bensdev-p/retro_machine_cad/docs/reference/physical-specification.png

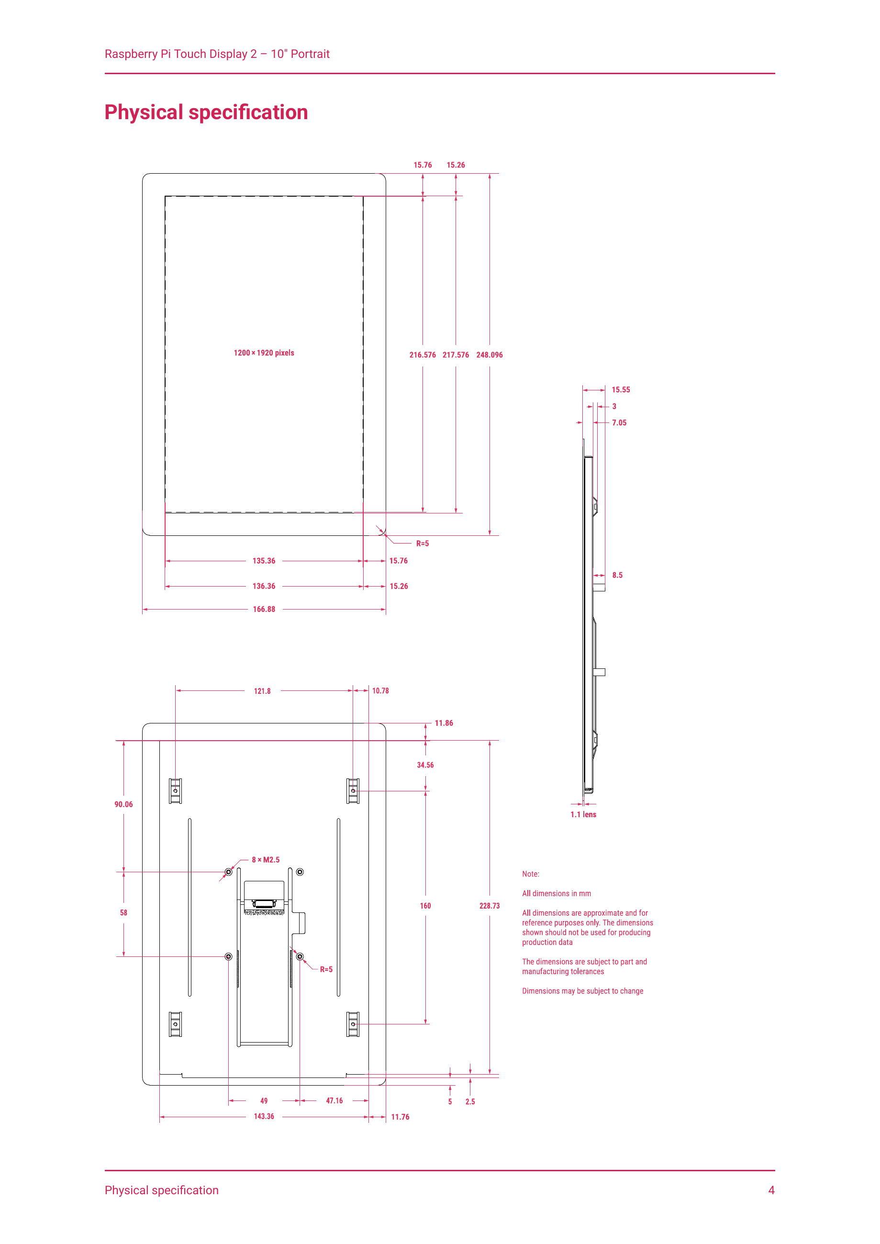
docs/reference/physical-specification.png
