bensdev-p/retro_machine_cad/outputs/front.png

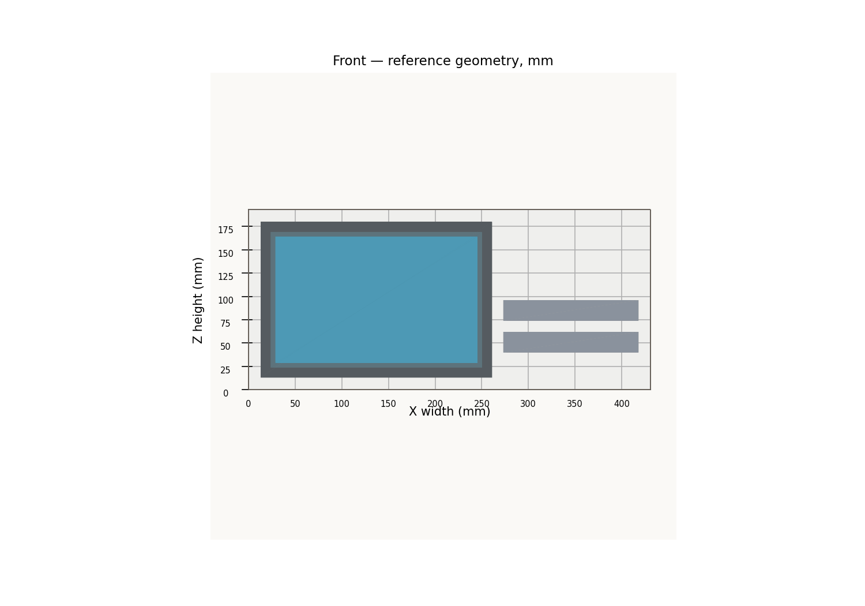
outputs/front.png
