bensdev-p/retro_machine_cad/outputs/keyboard_comparison.png

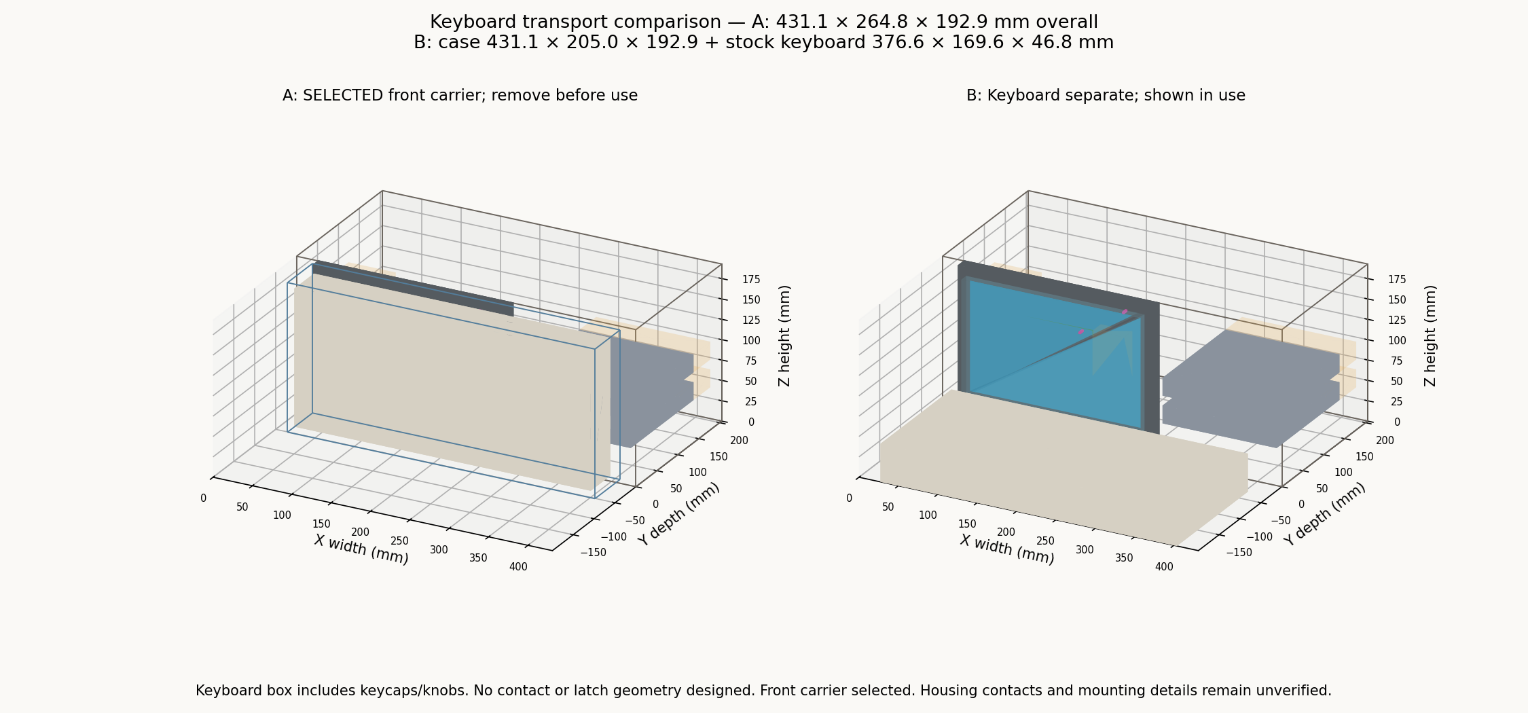
outputs/keyboard_comparison.png
