bensdev-p/retro_machine_cad/outputs/layout_views.png

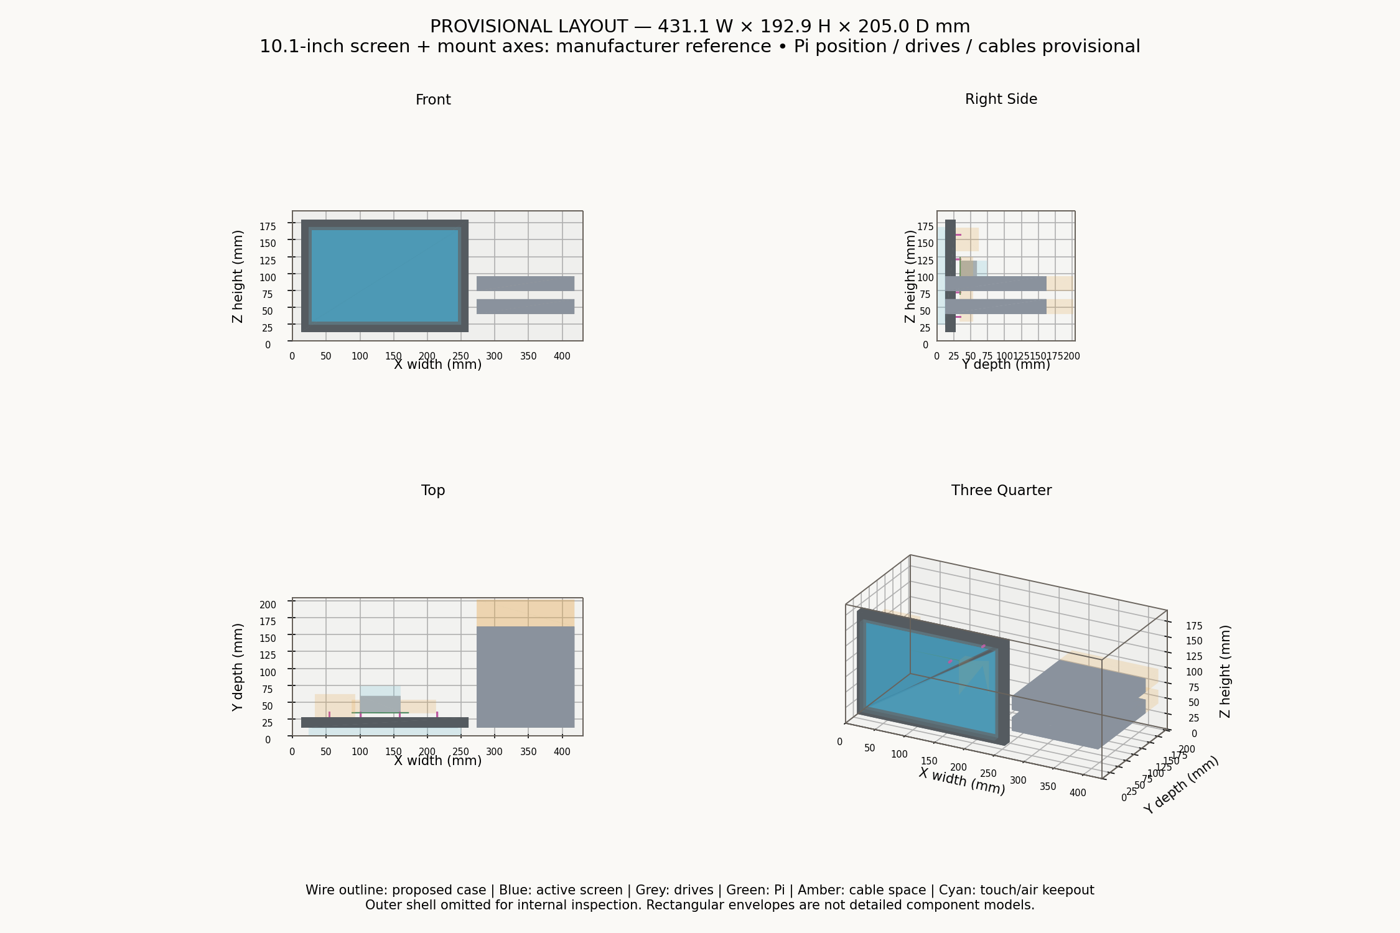
outputs/layout_views.png
