bensdev-p/retro_machine_cad/outputs/p2/previews/04_closed_classic.png

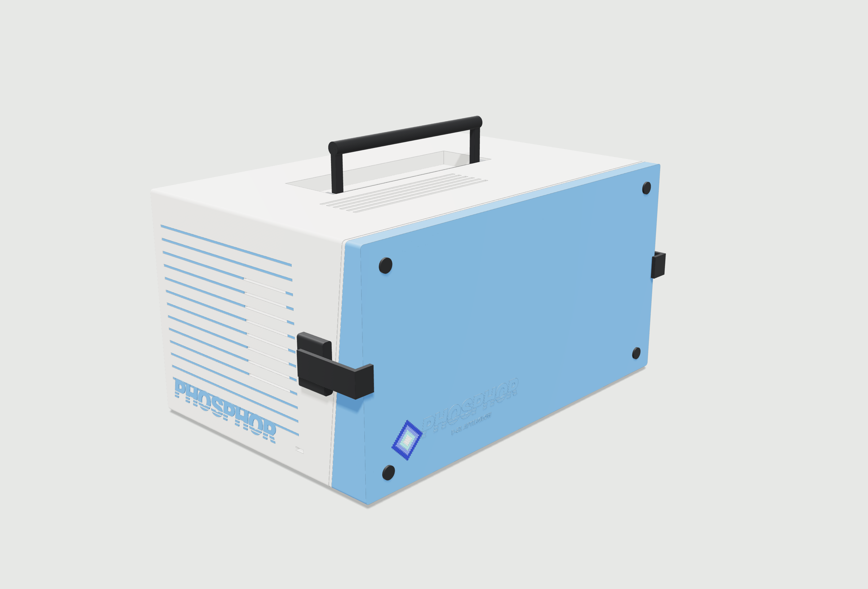
outputs/p2/previews/04_closed_classic.png
