bensdev-p/retro_machine_cad/outputs/p2/previews/05_rear_drawer.png

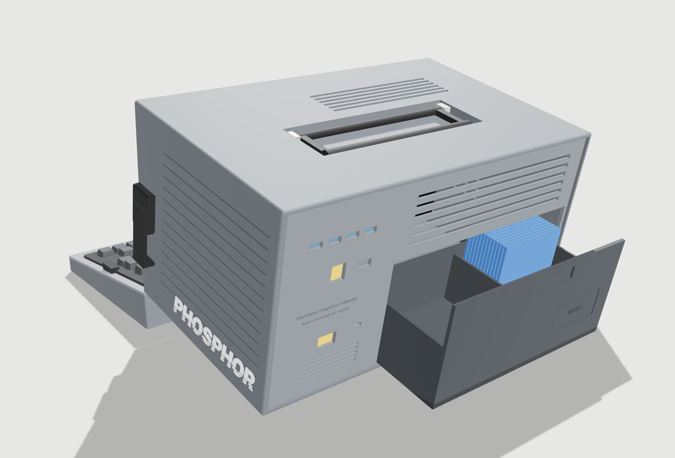
outputs/p2/previews/05_rear_drawer.png
