bensdev-p/retro_machine_cad/outputs/p2/previews/06_xray.png

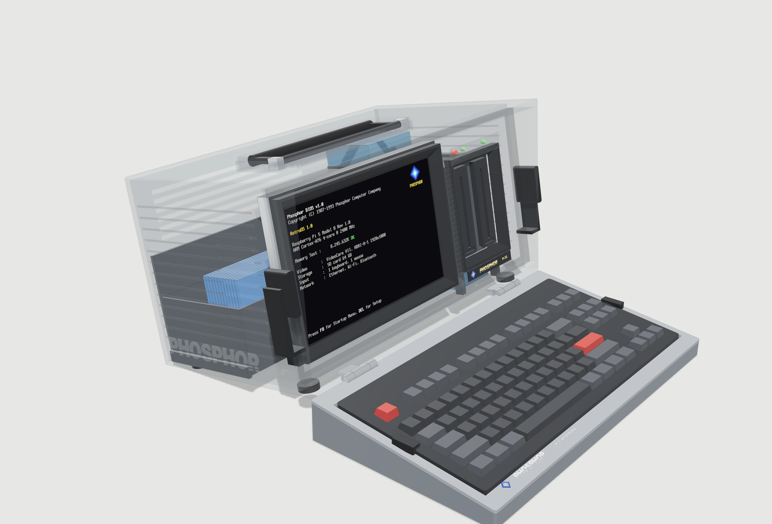
outputs/p2/previews/06_xray.png
