bensdev-p/retro_machine_cad/outputs/p2/previews/07_front.png

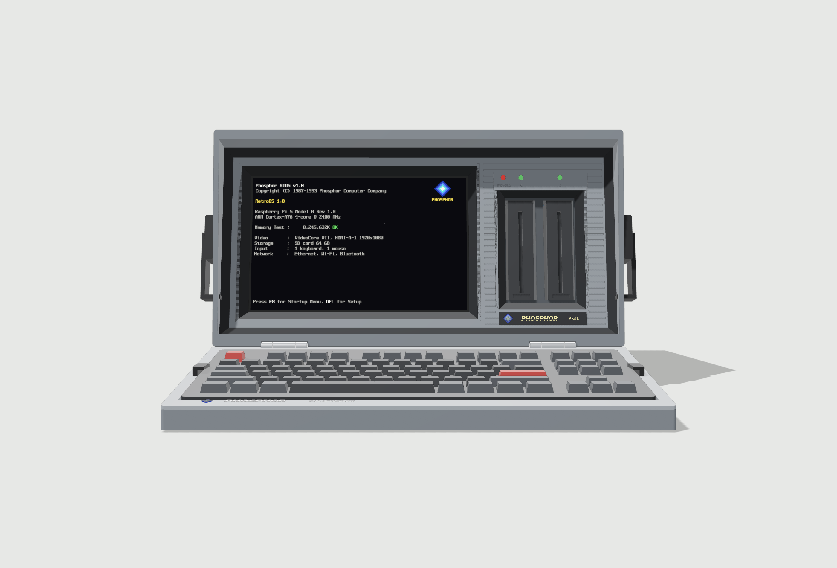
outputs/p2/previews/07_front.png
