bensdev-p/retro_machine_cad/outputs/p2/previews/08_side_closed.png

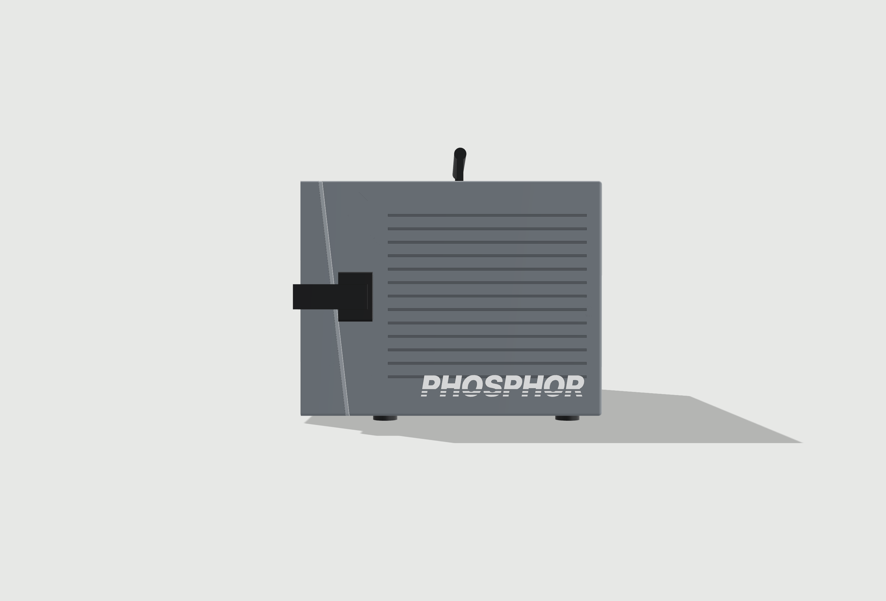
outputs/p2/previews/08_side_closed.png
