bensdev-p/retro_machine_cad/outputs/p2/screens/post.png

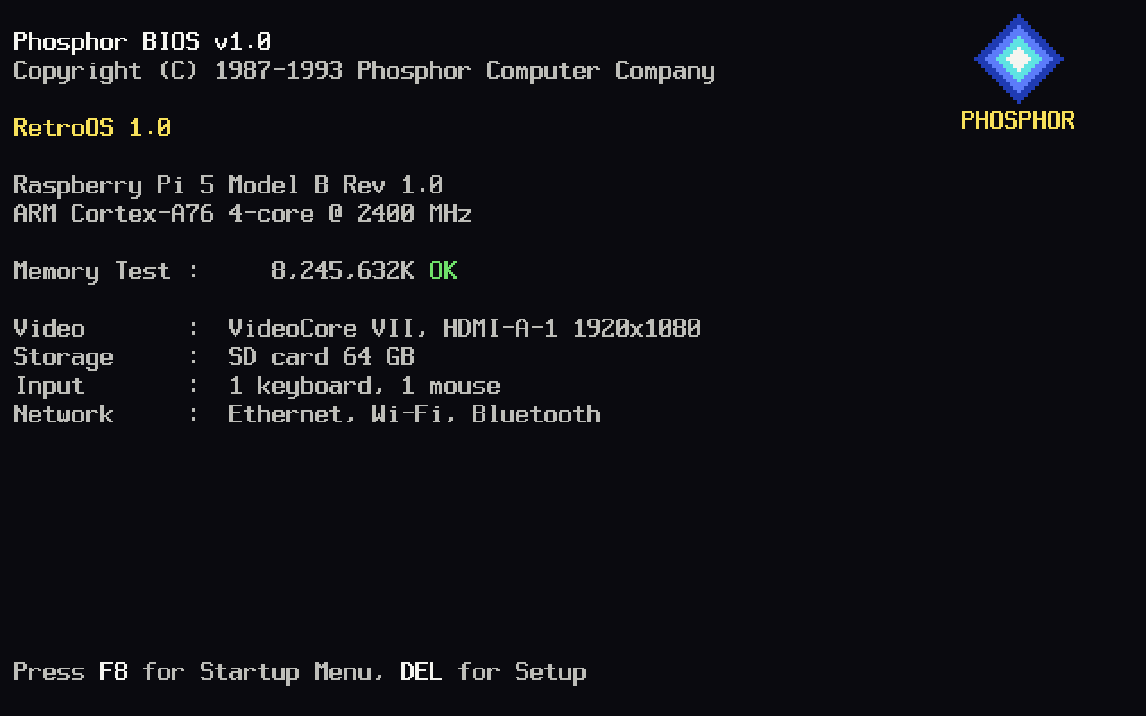
outputs/p2/screens/post.png
