bensdev-p/retro_machine_cad/outputs/p3/previews/p3_02_exploded.png

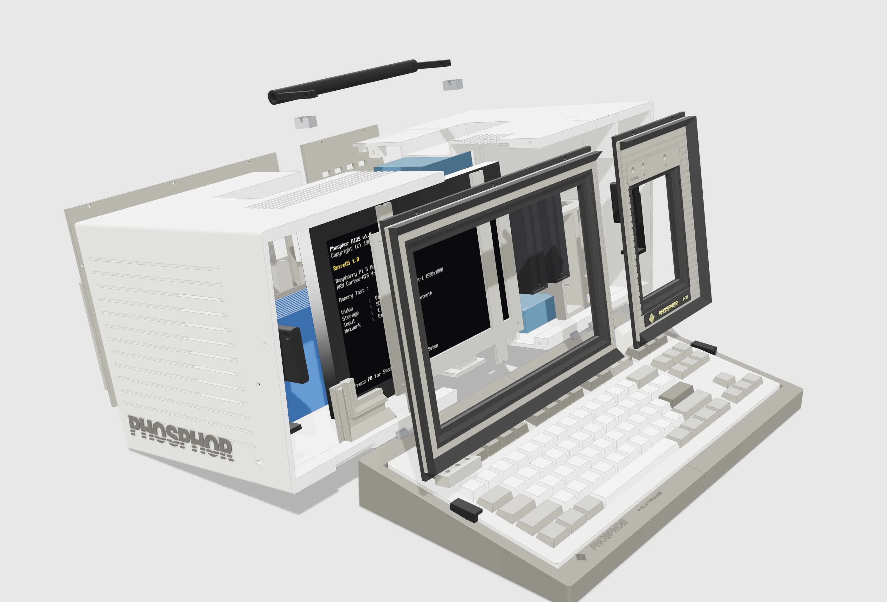
outputs/p3/previews/p3_02_exploded.png
