bensdev-p/retro_machine_cad/outputs/p3/previews/p3_04_xray.png

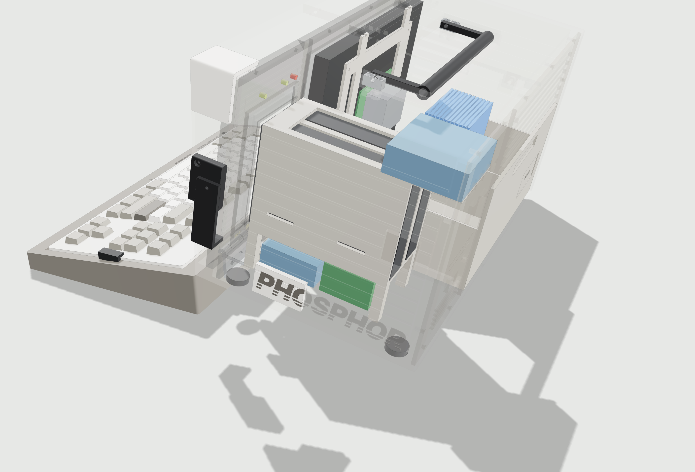
outputs/p3/previews/p3_04_xray.png
