bensdev-p/retro_machine_cad/outputs/prototype/previews/02_transport.png

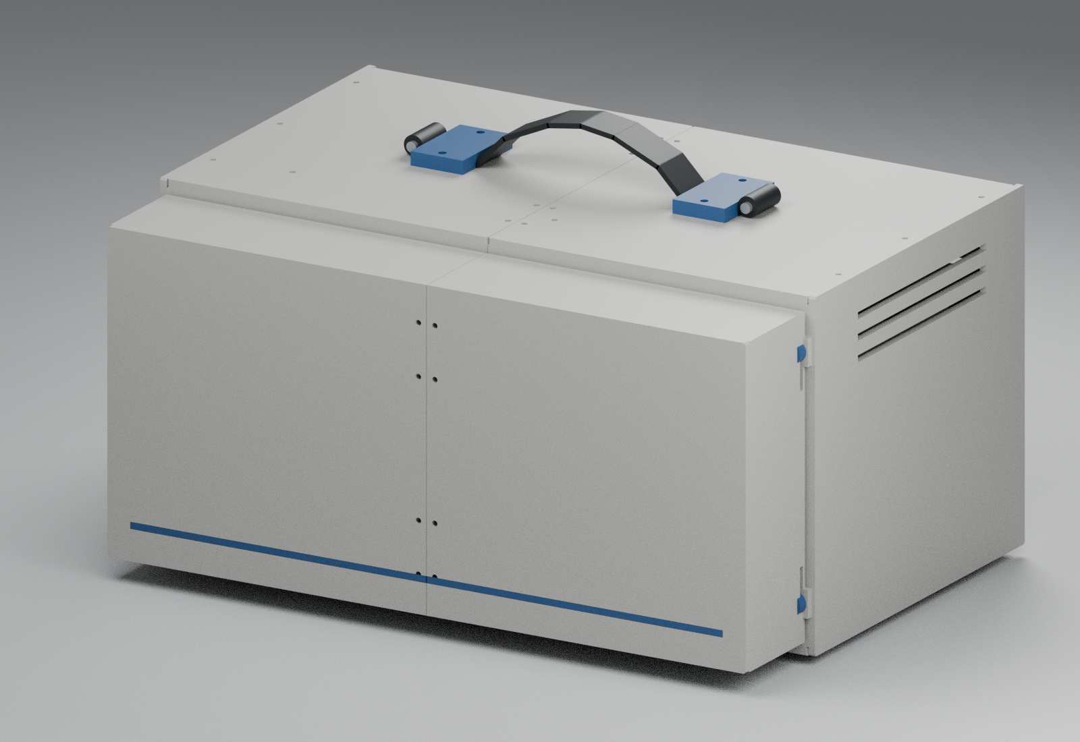
outputs/prototype/previews/02_transport.png
