bensdev-p/retro_machine_cad/outputs/prototype/previews/03_rear.png

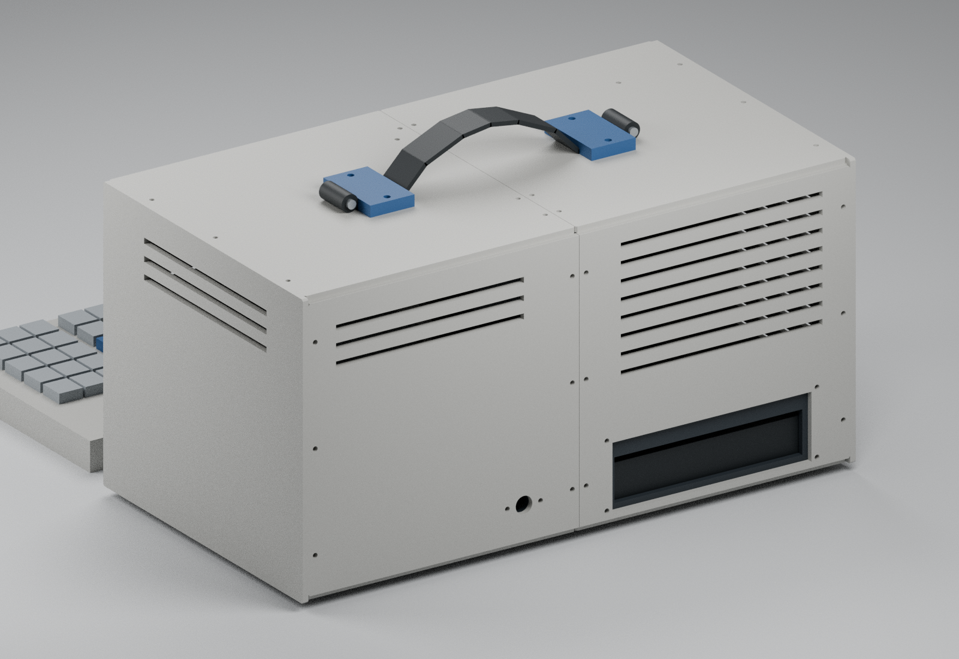
outputs/prototype/previews/03_rear.png
