bensdev-p/retro_machine_cad/outputs/prototype/previews/04_exploded.png

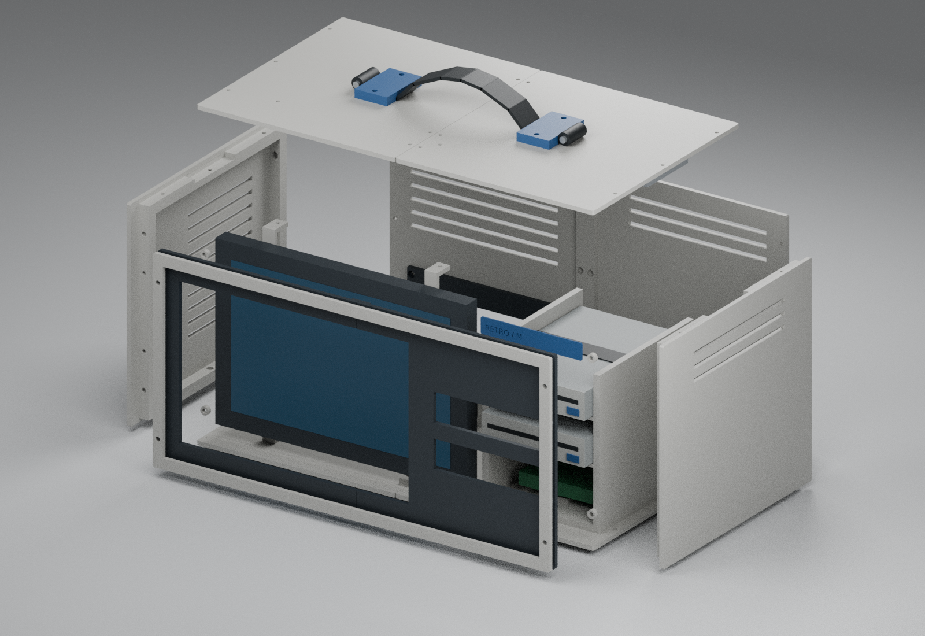
outputs/prototype/previews/04_exploded.png
