bensdev-p/retro_machine_cad/outputs/prototype/previews/05_front.png

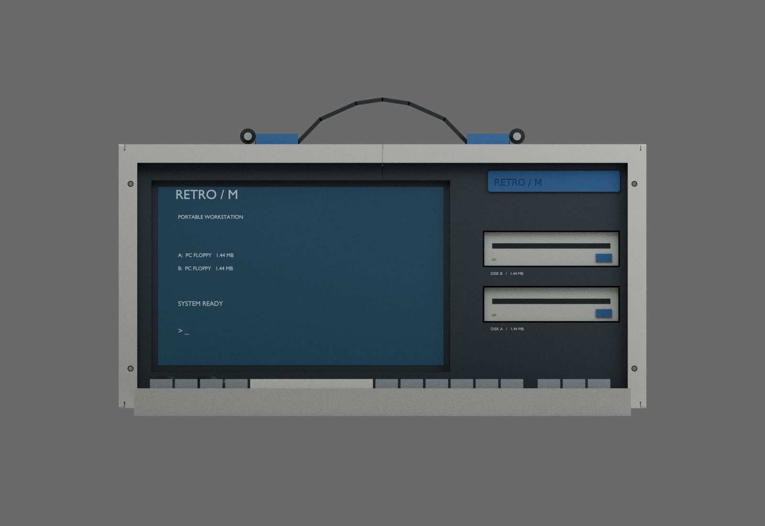
outputs/prototype/previews/05_front.png
