bensdev-p/retro_machine_cad/outputs/prototype/previews/06_interactive_viewer.png

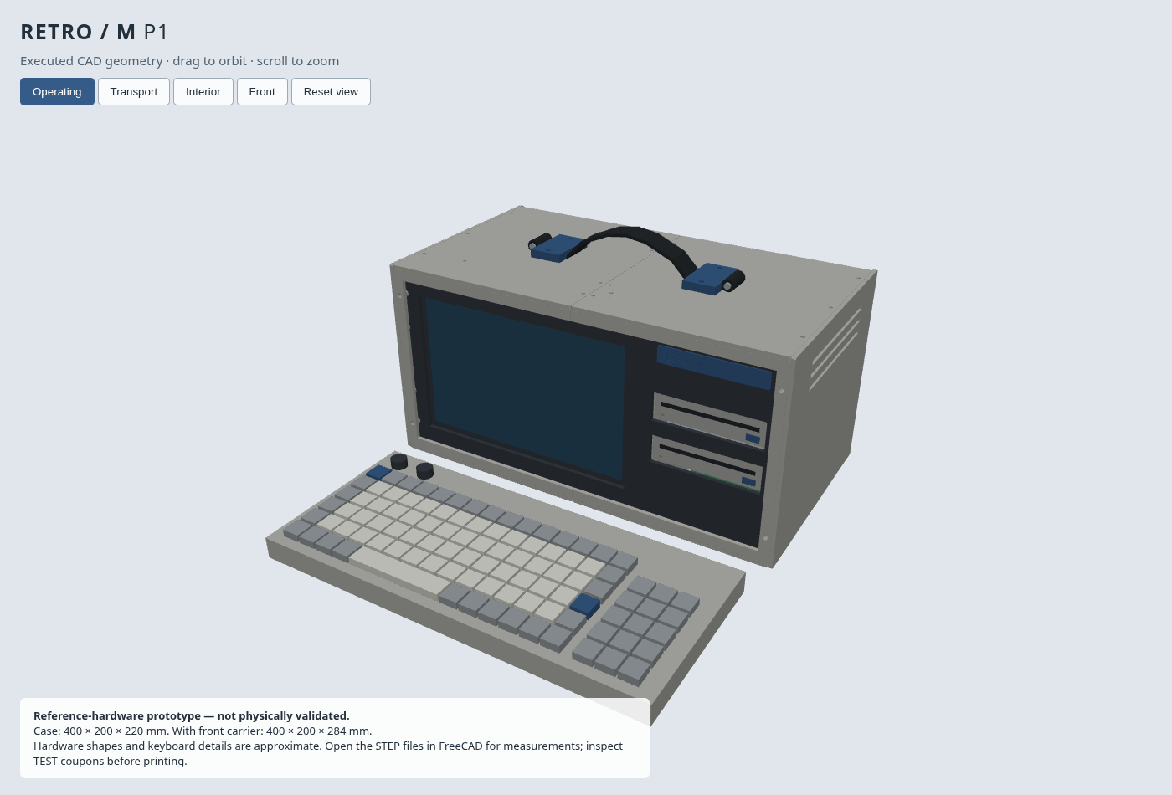
outputs/prototype/previews/06_interactive_viewer.png
