bensdev-p/retro_machine_cad/outputs/rear_internal.png

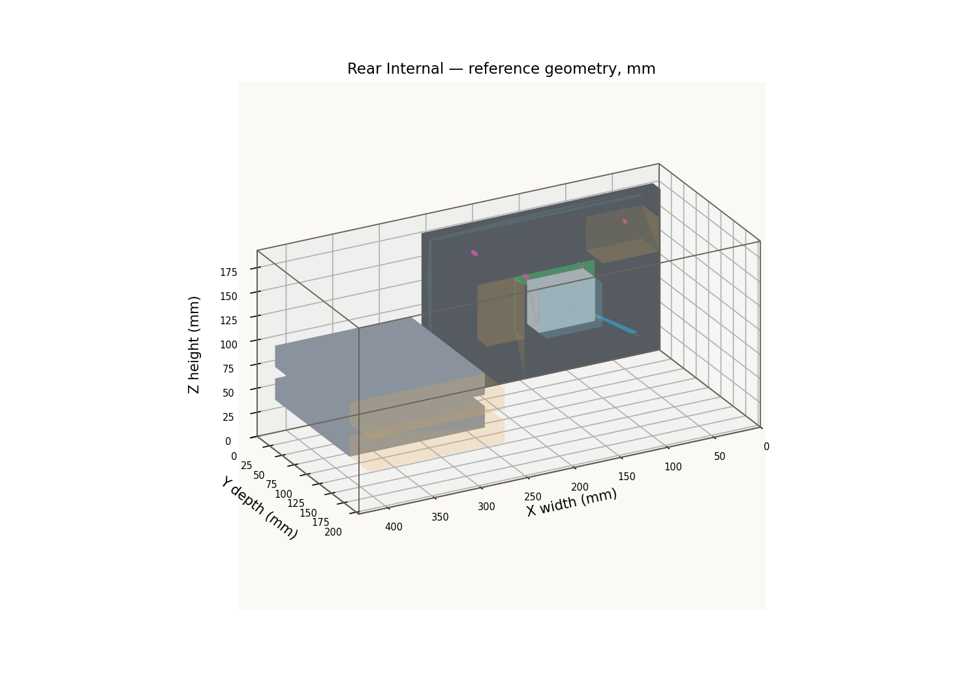
outputs/rear_internal.png
