bensdev-p/retro_machine_cad/outputs/rear_mounts.png

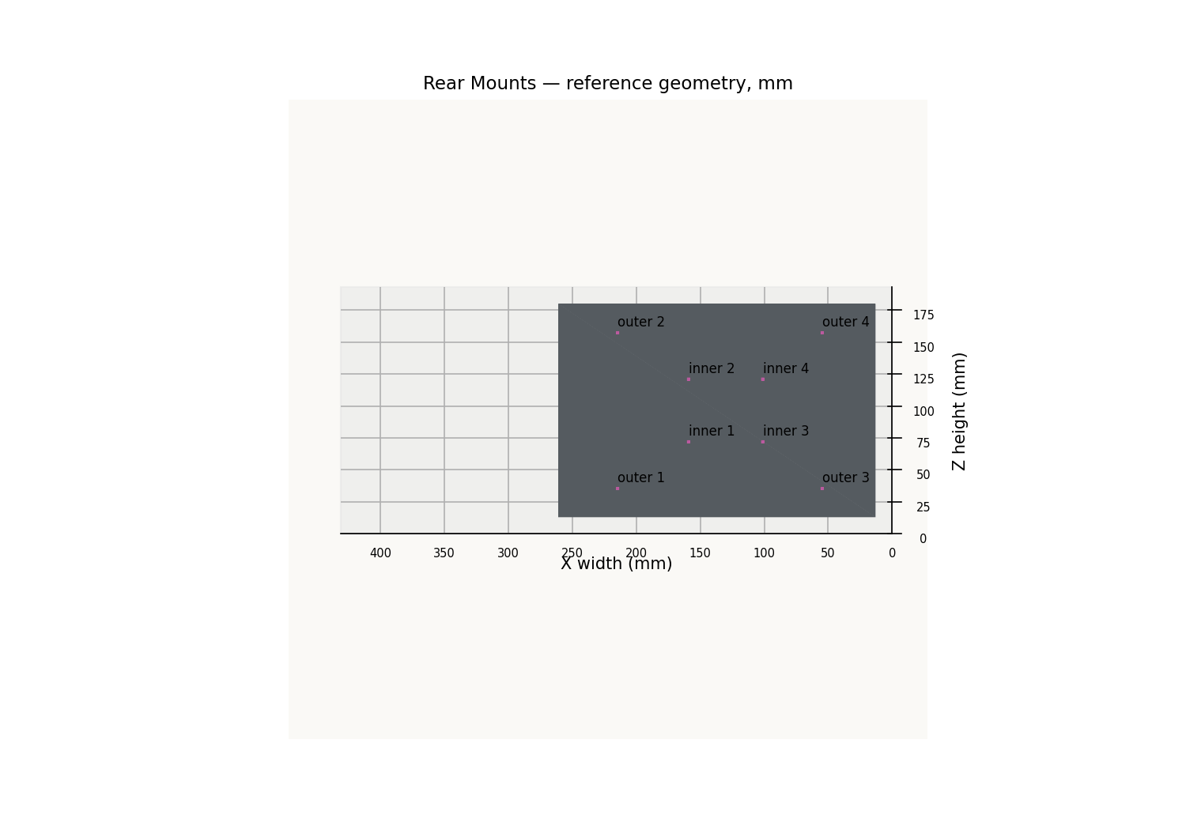
outputs/rear_mounts.png
