bensdev-p/retro_machine_cad/outputs/three_quarter.png

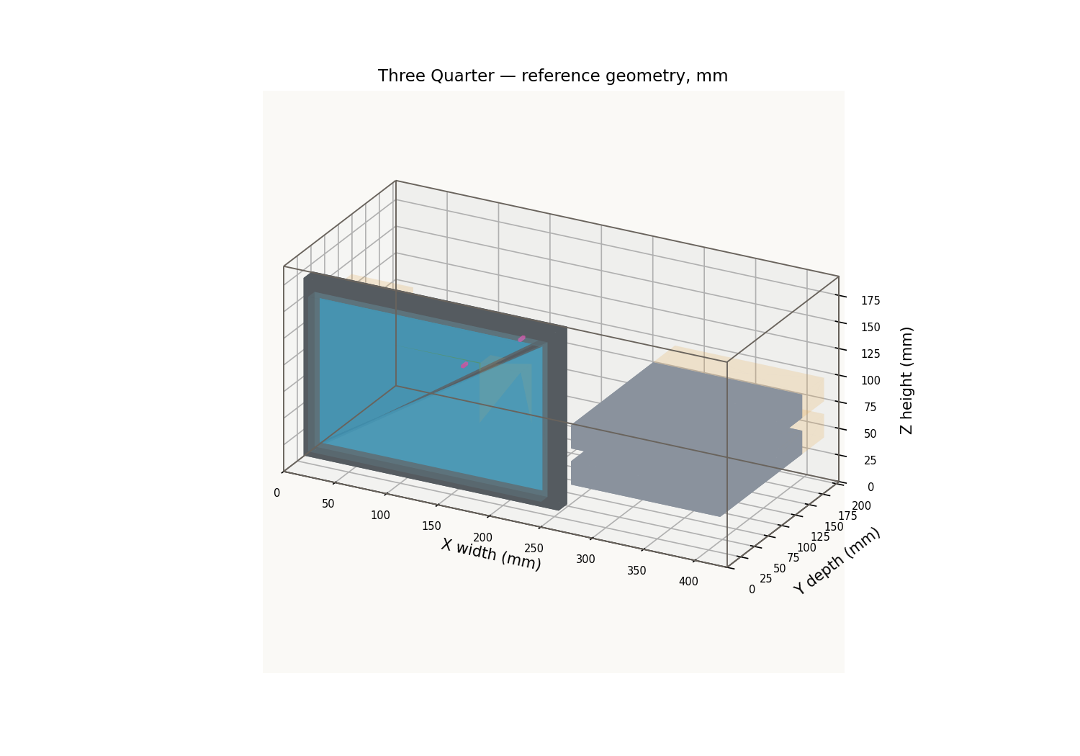
outputs/three_quarter.png
