bensdev-p/retro_machine_cad/outputs/top.png

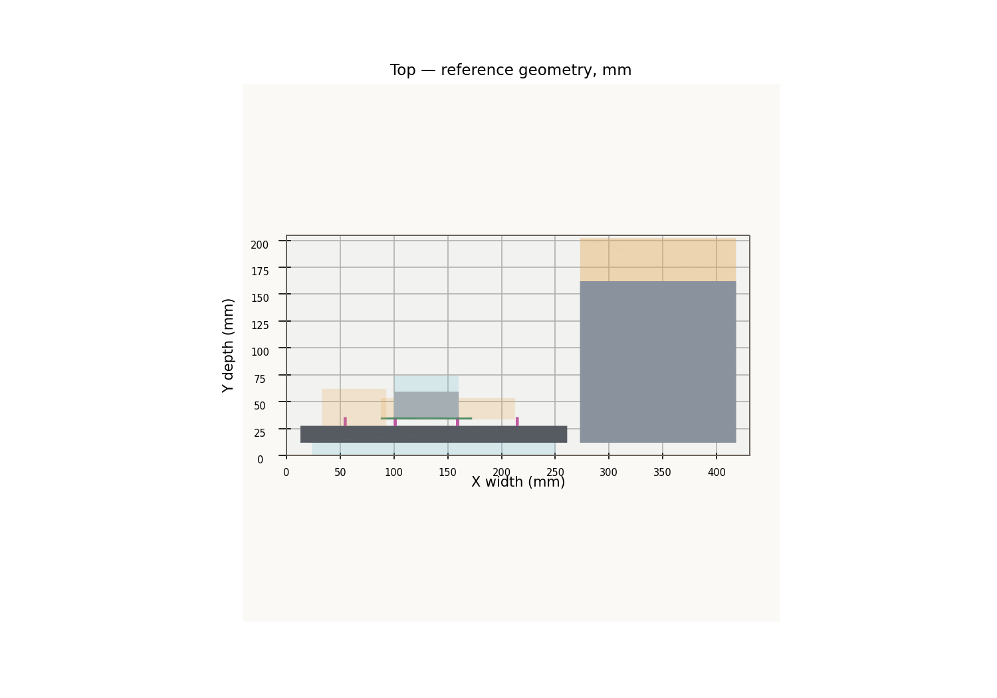
outputs/top.png
