bensdev-p/retro_machine_cad/outputs/p3/p3_assembly.step

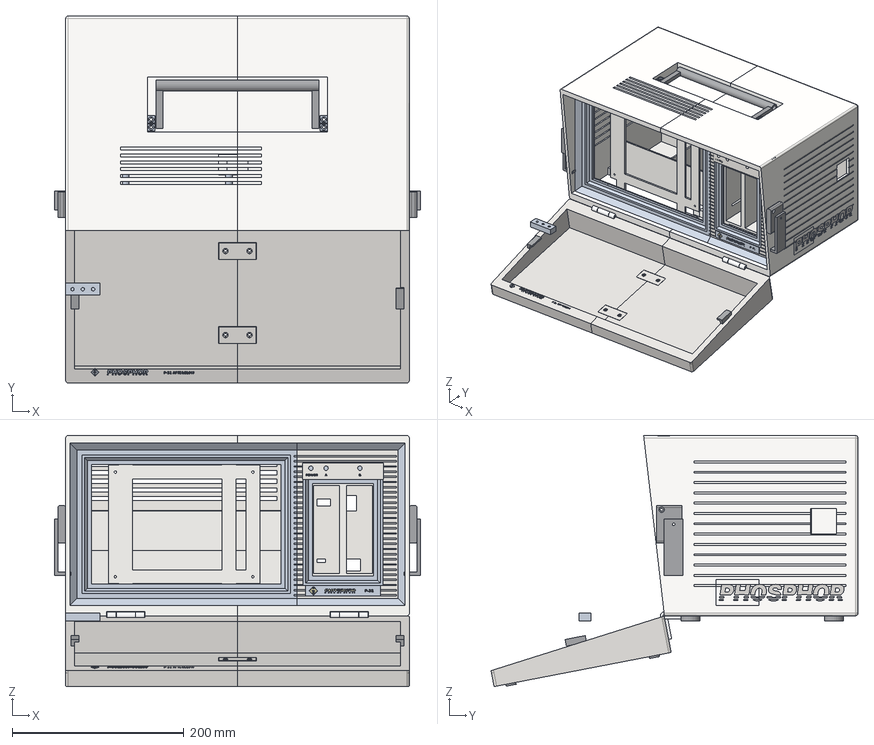
[picture p28: CAD file, 2026-11-11]
outputs/p3/p3_assembly.step
426.0 x 427.2 x 292.4 mm
shell_left
shell_right
bezel_drives_face
rear_panel_left
rear_io_plate
lid_left
lid_right
lid_splice_1
lid_splice_2
hinge_case_1
hinge_lid_1
hinge_case_2
hinge_lid_2
latch_base_left
latch_lever_left
latch_base_right
latch_lever_right
handle
drive_cage
drawer
keyboard_clip_1
keyboard_clip_2
display_bracket
foot_case_1
foot_case_2
foot_case_3
foot_case_4
coupon_C3_seam_L
coupon_C3_seam_R
coupon_C4_lip_corner
coupon_C5_inlay
ASSEMBLY x 19
