bensdev-p/retro_machine_cad/outputs/prototype/enclosure_assembly.step

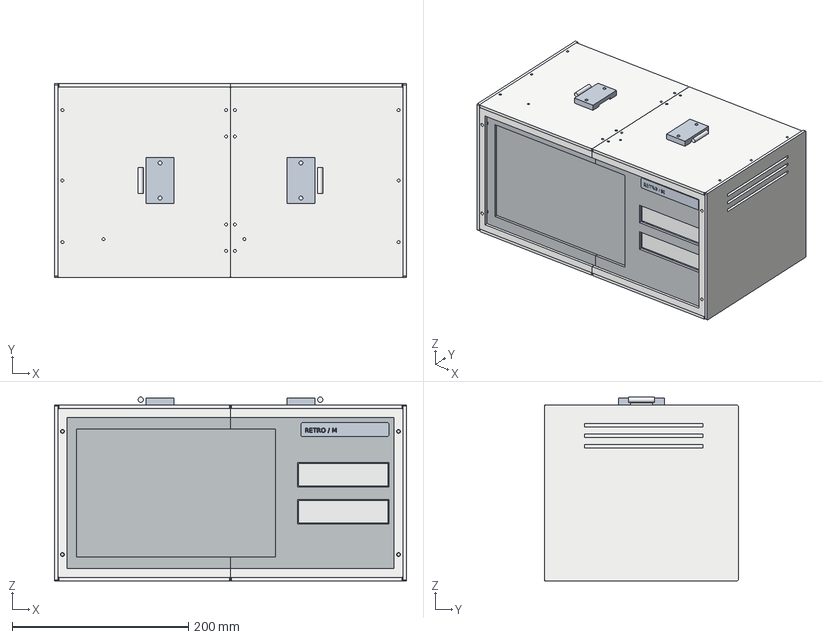
[picture p29: CAD file, 2026-11-05]
outputs/prototype/enclosure_assembly.step
400.0 x 220.0 x 209.0 mm
side_left
side_right
base_left
base_right
base_seam_1
base_seam_2
top_left
top_right
top_seam_1
top_seam_2
fascia_left
fascia_right
fascia_seam_1
fascia_seam_2
front_rim_left
front_rim_right
screen_support_1
screen_support_2
drive_cage_left
drive_cage_right
drive_cage_join_0
drive_cage_join_1
drive_cage_join_2
hub_cradle
rear_left
rear_right
rear_seam
rear_hub_plate
power_strain_relief
handle_backing_ALUMINIUM_NOT_PRINTED
