bensdev-p/retro_machine_cad/outputs/layout_A.step

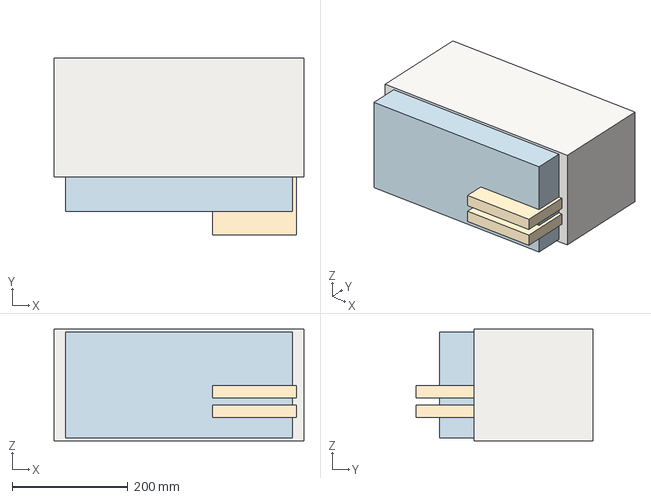
[picture p31: CAD file, 2026-11-05]
outputs/layout_A.step
431.1 x 305.0 x 192.9 mm
