bensdev-p/retro_machine_cad/outputs/p2/p2_closed.step

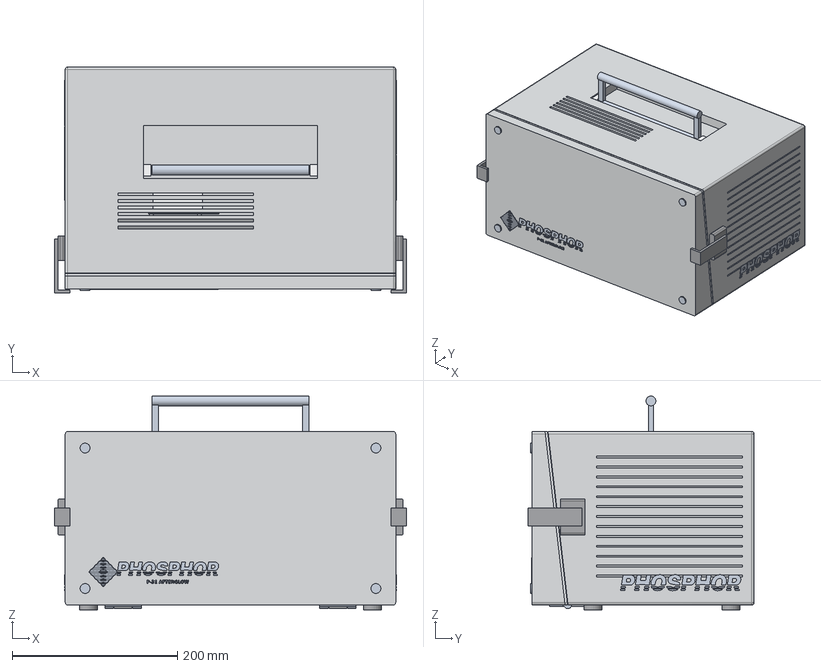
[picture p32: CAD file, 2026-11-11]
outputs/p2/p2_closed.step
426.0 x 274.0 x 259.0 mm
fascia
legend_plate
drive_cage
rear_panel
drawer
latch_lever_left
latch_lever_right
lid_body
lid_deck
