bensdev-p/retro_machine_cad/outputs/p3/3mf/lid_left.3mf

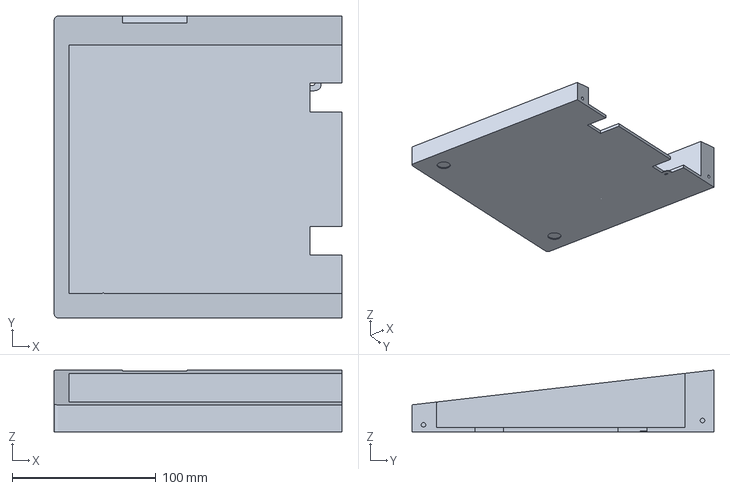
[picture p33: CAD file, 2026-11-11]
outputs/p3/3mf/lid_left.3mf
200.0 x 210.0 x 43.1 mm
