bensdev-p/retro_machine_cad/outputs/p3/stl/keyboard_clip_1.stl

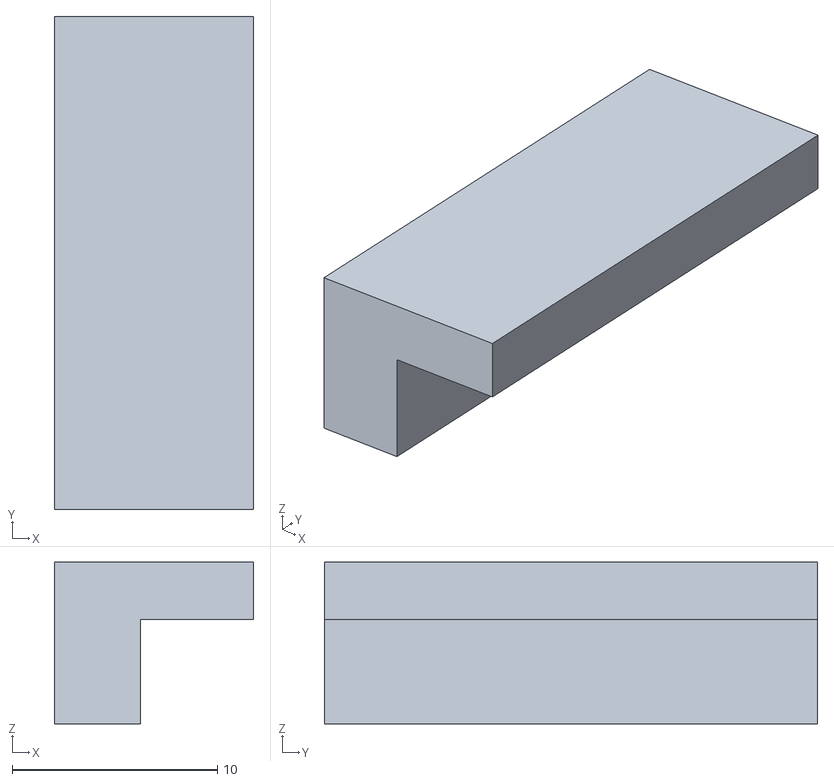
[picture p34: CAD file, 2026-11-11]
outputs/p3/stl/keyboard_clip_1.stl
9.70 x 24.0 x 7.88
