bensdev-p/retro_machine_cad/outputs/prototype/parts/TEST_alignment_left.step

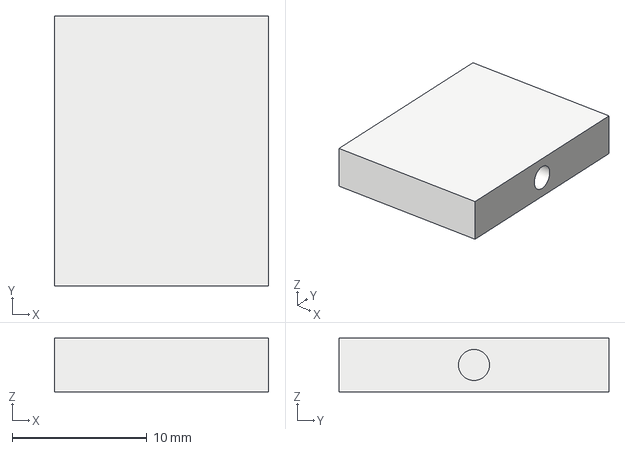
[picture p35: CAD file, 2026-11-05]
outputs/prototype/parts/TEST_alignment_left.step
15.9 x 20.0 x 4.00 mm
