bensdev-p/retro_machine_cad/outputs/step_parts/cooler_placeholder.step

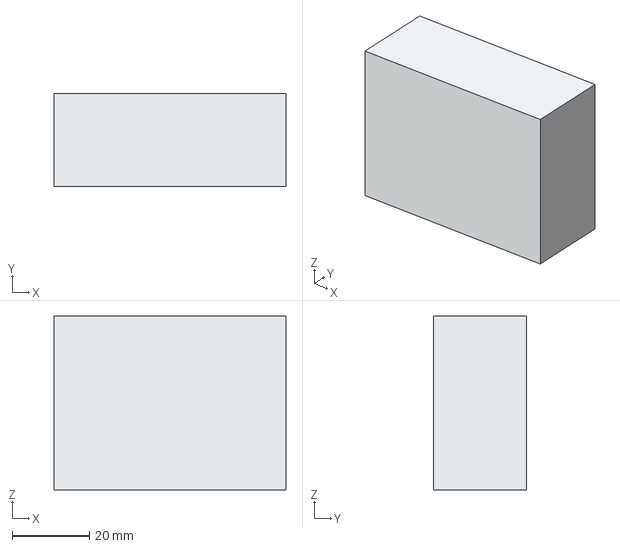
[picture p36: CAD file, 2026-11-05]
outputs/step_parts/cooler_placeholder.step
60.0 x 24.0 x 45.0 mm
