bensdev-p/retro_machine_cad/outputs/layout_B.step

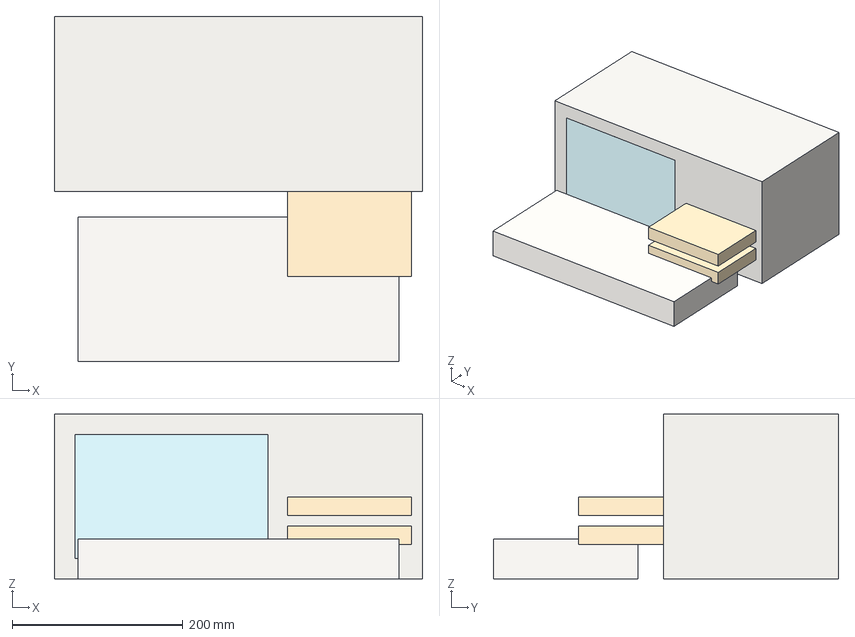
[picture p37: CAD file, 2026-11-05]
outputs/layout_B.step
431.1 x 404.6 x 192.9 mm
