bensdev-p/retro_machine_cad/outputs/p2/p2_operating.step

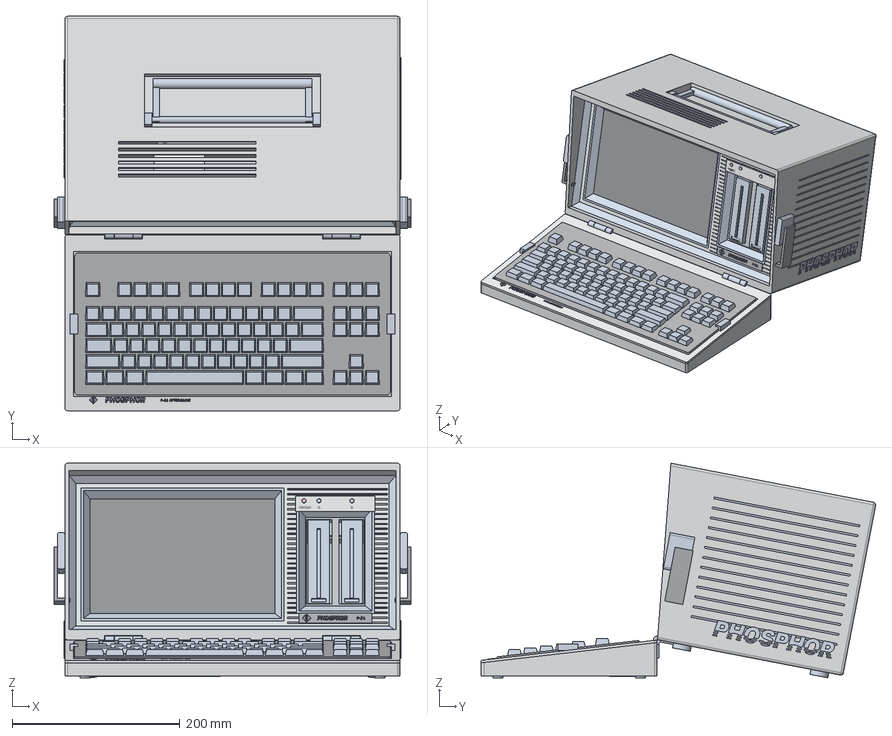
[picture p38: CAD file, 2026-11-11]
outputs/p2/p2_operating.step
426.0 x 470.8 x 256.1 mm
fascia
legend_plate
drive_cage
rear_panel
drawer
latch_lever_left
latch_lever_right
lid_body
lid_deck
