bensdev-p/retro_machine_cad/outputs/p3/3mf/bezel_screen.3mf

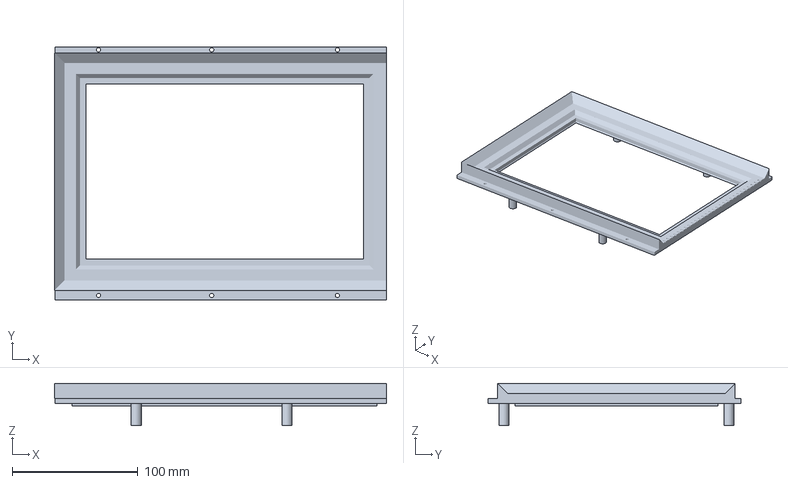
[picture p39: CAD file, 2026-11-11]
outputs/p3/3mf/bezel_screen.3mf
264.0 x 201.5 x 33.5 mm
