bensdev-p/retro_machine_cad/outputs/p3/stl/coupon_C4_lip_corner.stl

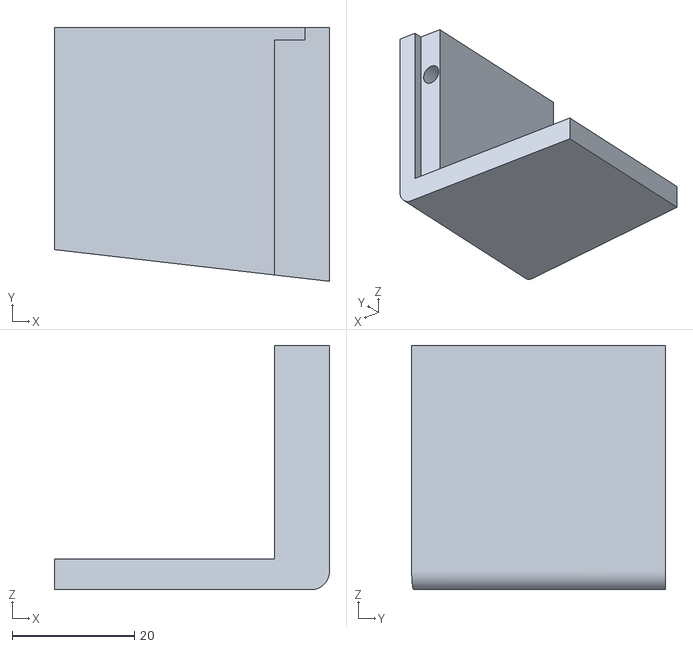
[picture p40: CAD file, 2026-11-11]
outputs/p3/stl/coupon_C4_lip_corner.stl
45.0 x 41.5 x 40.0
