bensdev-p/retro_machine_cad/outputs/prototype/parts/drive_cage_right.step

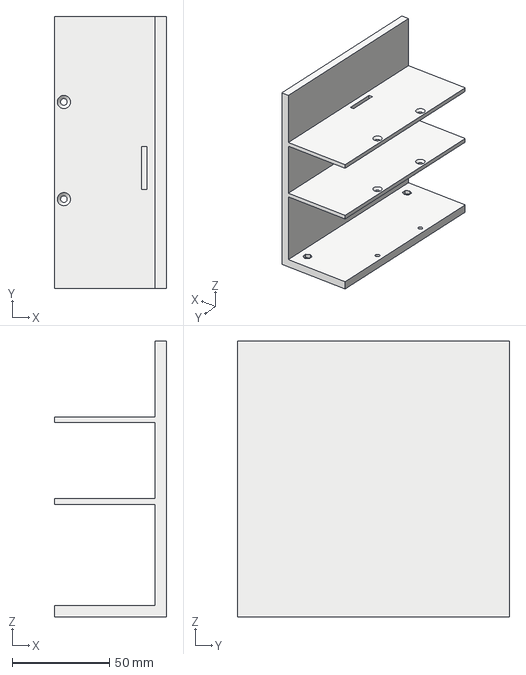
[picture p41: CAD file, 2026-11-05]
outputs/prototype/parts/drive_cage_right.step
57.7 x 140.0 x 142.0 mm
