bensdev-p/retro_machine_cad/outputs/step_parts/display_inner_mount_axis_3.step

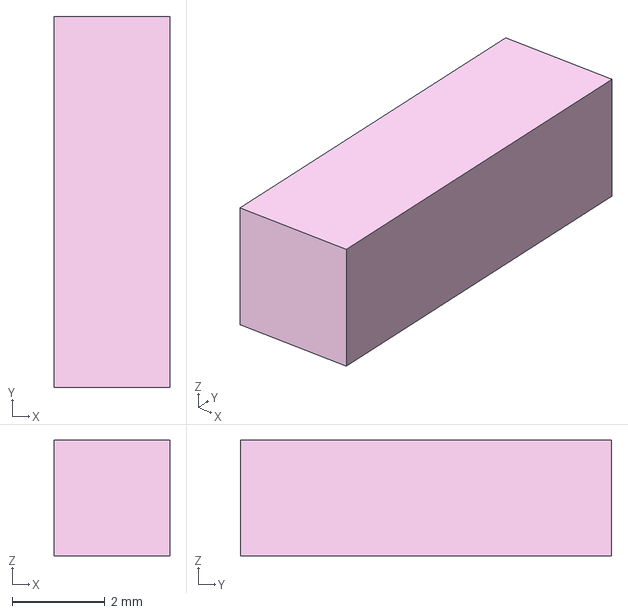
[picture p42: CAD file, 2026-11-05]
outputs/step_parts/display_inner_mount_axis_3.step
2.50 x 8.00 x 2.50 mm
