bensdev-p/retro_machine_cad/outputs/p3/3mf/coupon_C5_inlay.3mf

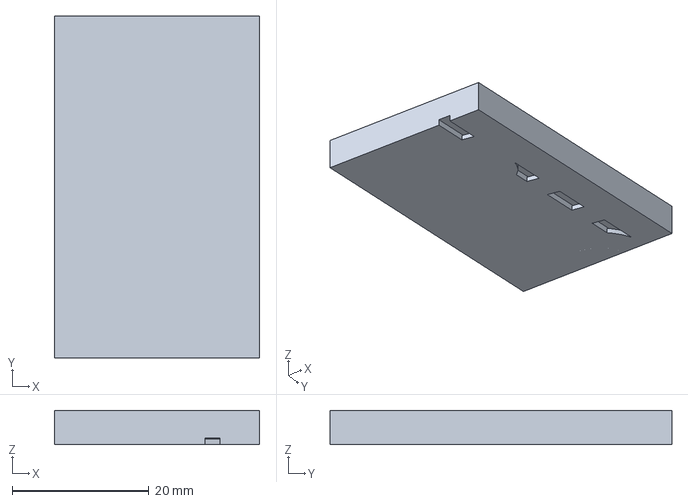
[picture p43: CAD file, 2026-11-11]
outputs/p3/3mf/coupon_C5_inlay.3mf
30.0 x 50.0 x 5.00 mm
