bensdev-p/retro_machine_cad/outputs/p3/stl/lid_splice_2.stl

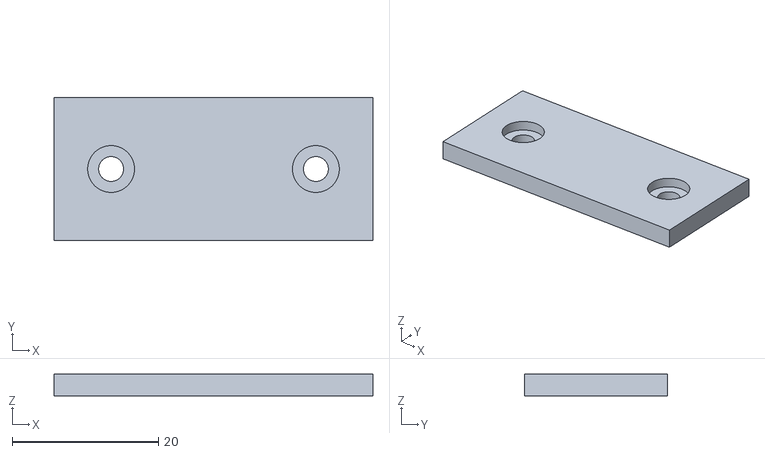
[picture p44: CAD file, 2026-11-11]
outputs/p3/stl/lid_splice_2.stl
43.6 x 19.6 x 3.00
