bensdev-p/retro_machine_cad/outputs/prototype/handle_backing_aluminium.step

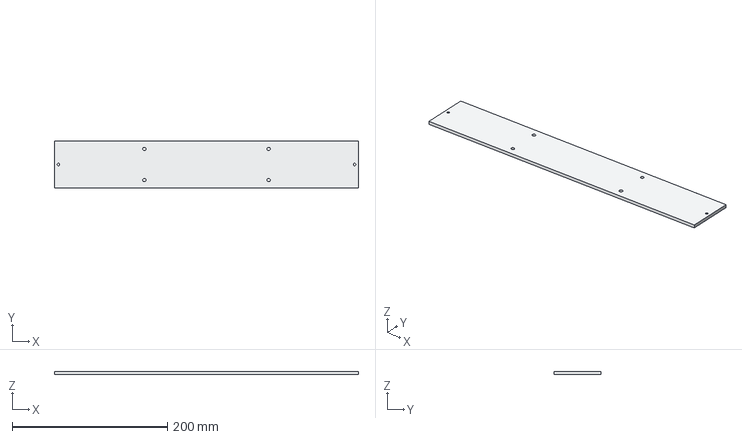
[picture p45: CAD file, 2026-11-05]
outputs/prototype/handle_backing_aluminium.step
392.0 x 60.0 x 4.00 mm
