bensdev-p/retro_machine_cad/outputs/prototype/parts/rim_spacer_right_170.step

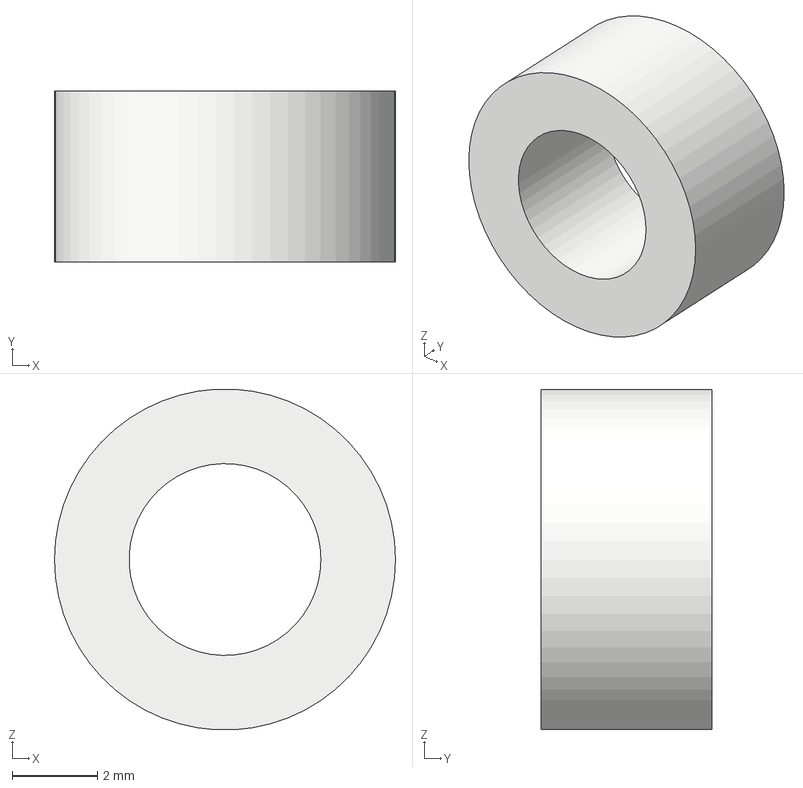
[picture p46: CAD file, 2026-11-05]
outputs/prototype/parts/rim_spacer_right_170.step
8.00 x 4.00 x 7.99 mm
