bensdev-p/retro_machine_cad/outputs/step_parts/drive_1_disk_access.step

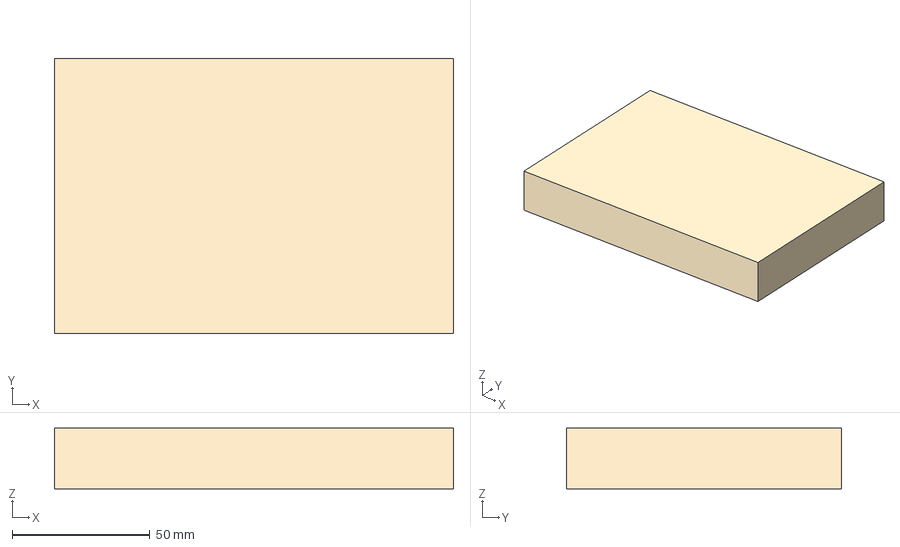
[picture p47: CAD file, 2026-11-05]
outputs/step_parts/drive_1_disk_access.step
145.0 x 100.0 x 22.0 mm
