bensdev-p/retro_machine_cad/outputs/p3/3mf/shell_left.3mf

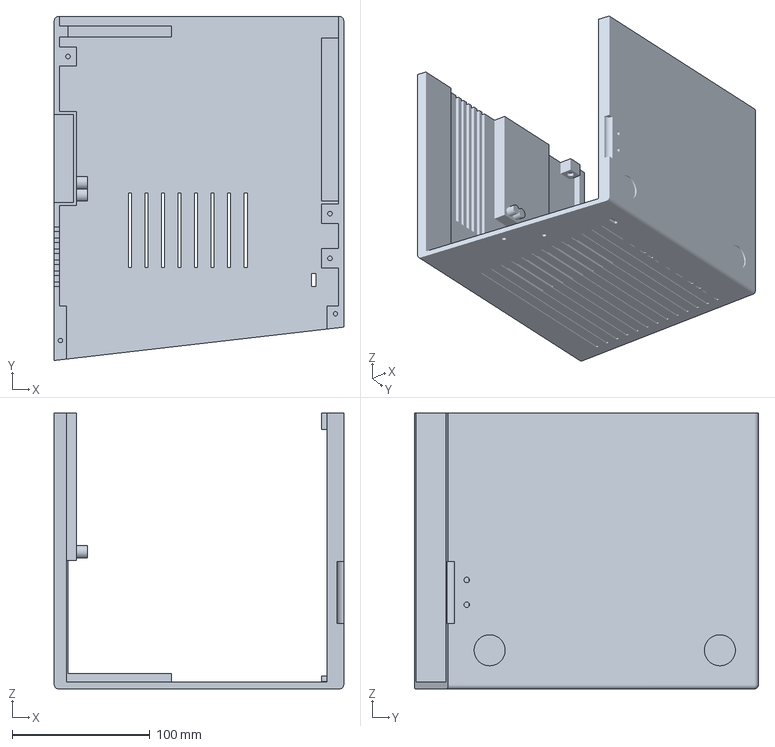
[picture p48: CAD file, 2026-11-11]
outputs/p3/3mf/shell_left.3mf
210.0 x 249.5 x 200.0 mm
