bensdev-p/retro_machine_cad/outputs/prototype/handle_backing_drill_template.dxf

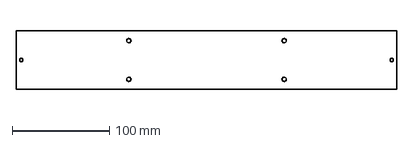
[picture p50: CAD file, 2026-11-05]
outputs/prototype/handle_backing_drill_template.dxf
392.0 x 60.0 mm
