bensdev-p/retro_machine_cad/outputs/prototype/parts/side_left.step

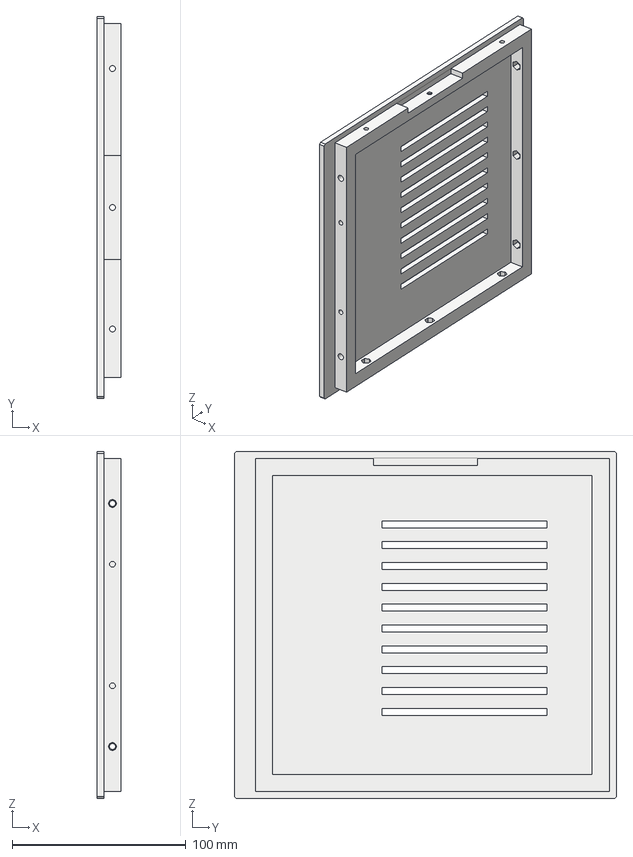
[picture p51: CAD file, 2026-11-05]
outputs/prototype/parts/side_left.step
14.0 x 220.0 x 200.0 mm
