bensdev-p/retro_machine_cad/outputs/step_parts/display_reference_envelope.step

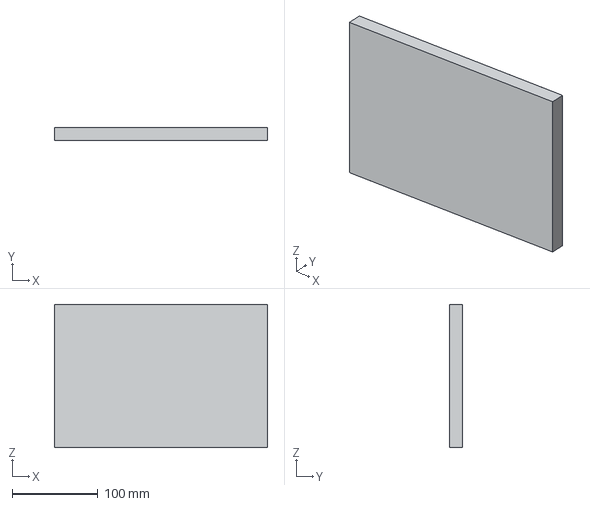
[picture p52: CAD file, 2026-11-05]
outputs/step_parts/display_reference_envelope.step
248.1 x 15.6 x 166.9 mm
