bensdev-p/retro_machine_cad/outputs/p3/3mf/bezel_drives.3mf

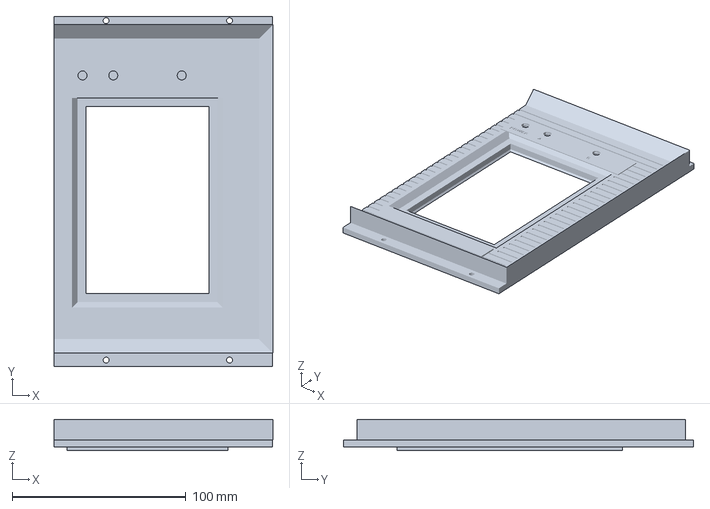
[picture p53: CAD file, 2026-11-11]
outputs/p3/3mf/bezel_drives.3mf
126.0 x 201.5 x 18.0 mm
