bensdev-p/retro_machine_cad/outputs/step_parts/keyboard_B_separate.step

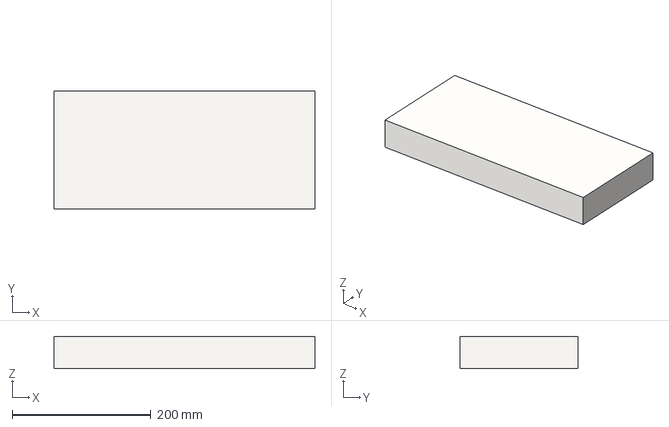
[picture p54: CAD file, 2026-11-05]
outputs/step_parts/keyboard_B_separate.step
376.6 x 169.6 x 46.8 mm
