bensdev-p/retro_machine_cad/outputs/p3/stl/coupon_C6_shroud_corner.stl

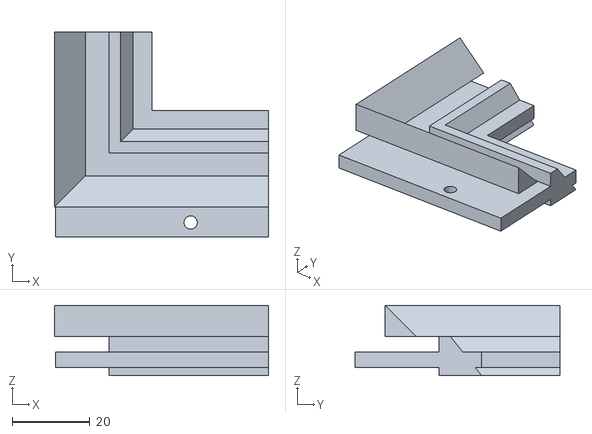
[picture p56: CAD file, 2026-11-11]
outputs/p3/stl/coupon_C6_shroud_corner.stl
55.0 x 52.7 x 18.0
