bensdev-p/retro_machine_cad/outputs/step_parts/case_envelope.step

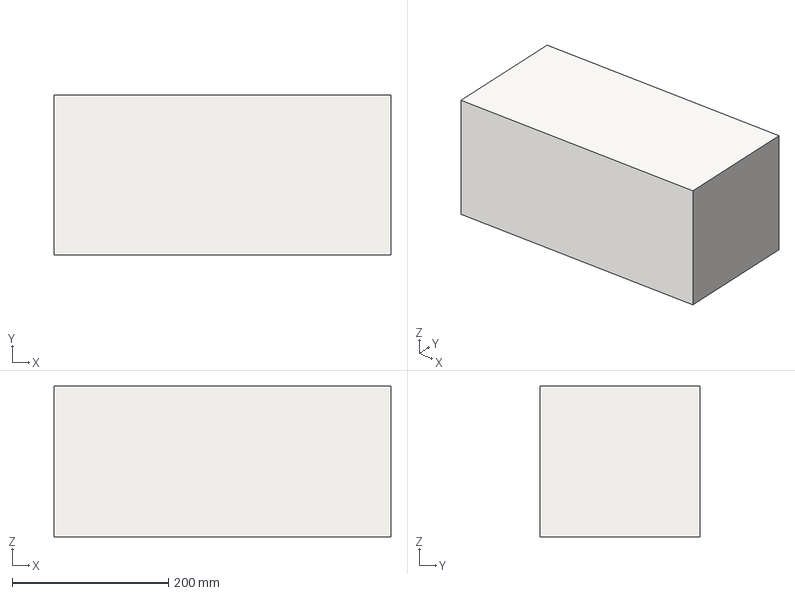
[picture p57: CAD file, 2026-11-05]
outputs/step_parts/case_envelope.step
431.1 x 205.0 x 192.9 mm
