bensdev-p/retro_machine_cad/outputs/p3/stl/latch_lever_right.stl

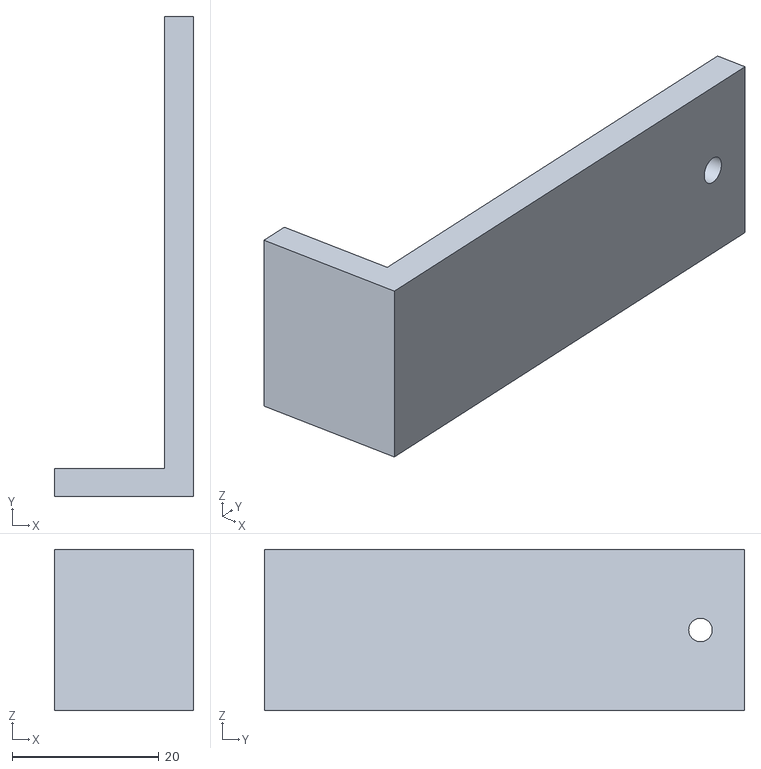
[picture p58: CAD file, 2026-11-11]
outputs/p3/stl/latch_lever_right.stl
19.0 x 65.4 x 22.0
