bensdev-p/retro_machine_cad/outputs/prototype/parts/handle_clamp_2.step

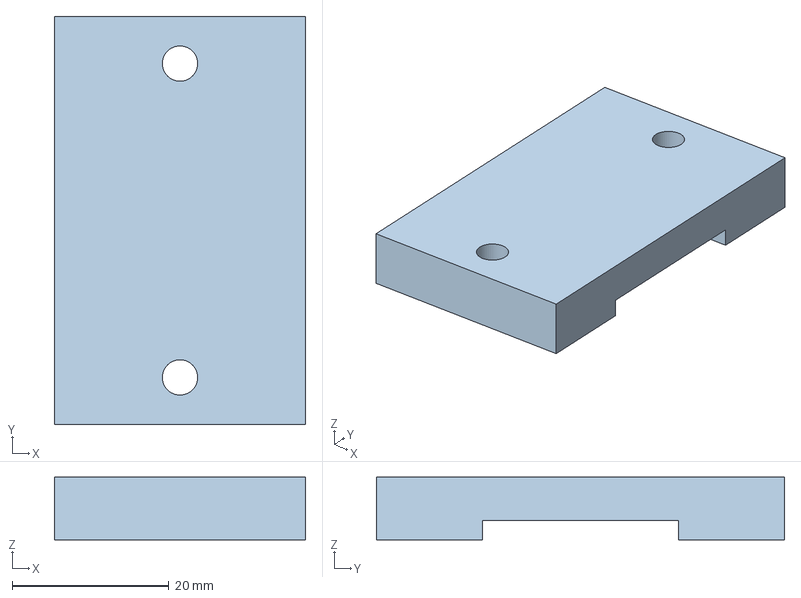
[picture p59: CAD file, 2026-11-05]
outputs/prototype/parts/handle_clamp_2.step
32.0 x 52.0 x 8.00 mm
