bensdev-p/retro_machine_cad/outputs/step_parts/active_area_reference.step

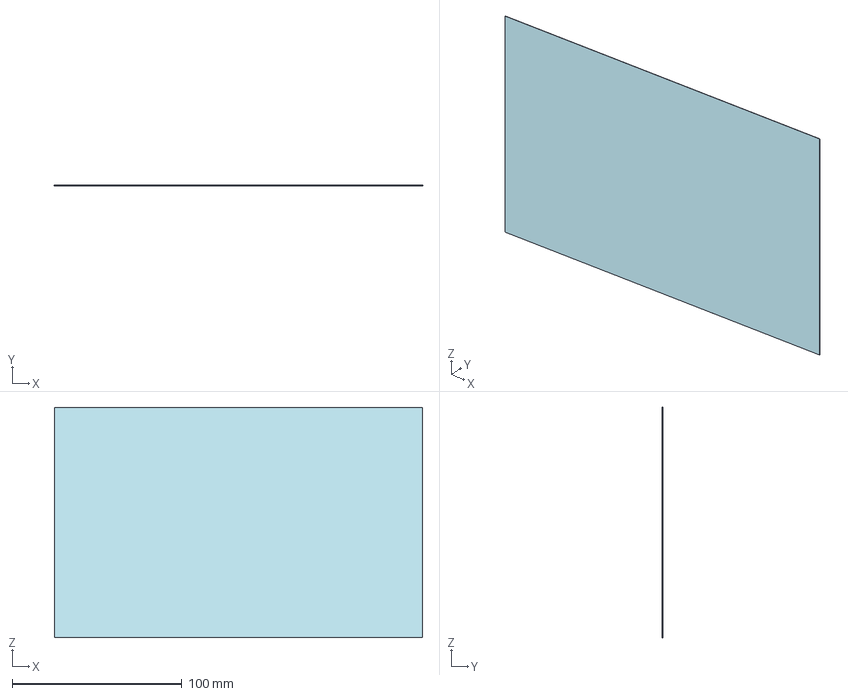
[picture p60: CAD file, 2026-11-05]
outputs/step_parts/active_area_reference.step
216.6 x 0.2 x 135.4 mm
