bensdev-p/retro_machine_cad/outputs/p3/stl/lid_left__inlay_lid_deck.stl

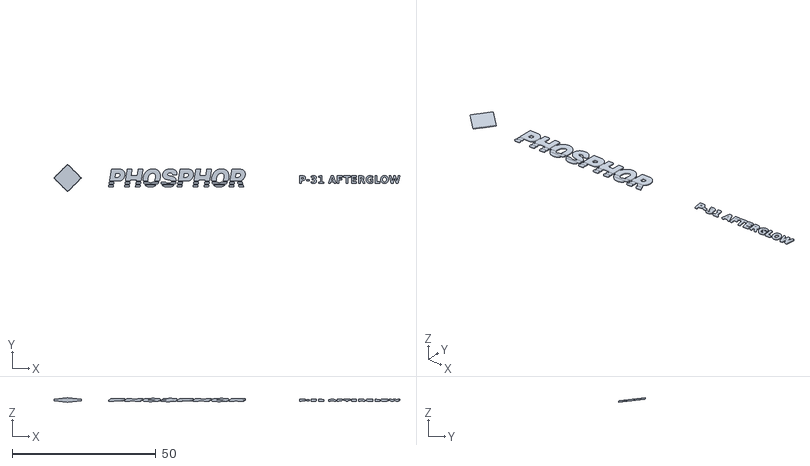
[picture p61: CAD file, 2026-11-11]
outputs/p3/stl/lid_left__inlay_lid_deck.stl
120.3 x 9.49 x 1.58
