bensdev-p/retro_machine_cad/outputs/prototype/parts/carrier_blue_inlay_right.step

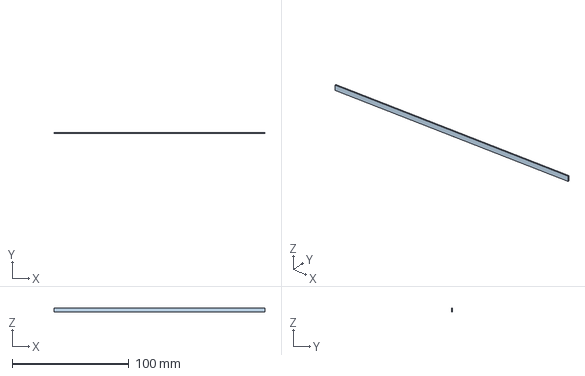
[picture p62: CAD file, 2026-11-05]
outputs/prototype/parts/carrier_blue_inlay_right.step
180.6 x 0.85 x 3.70 mm
