bensdev-p/retro_machine_cad/outputs/p3/stl/hinge_case_2.stl

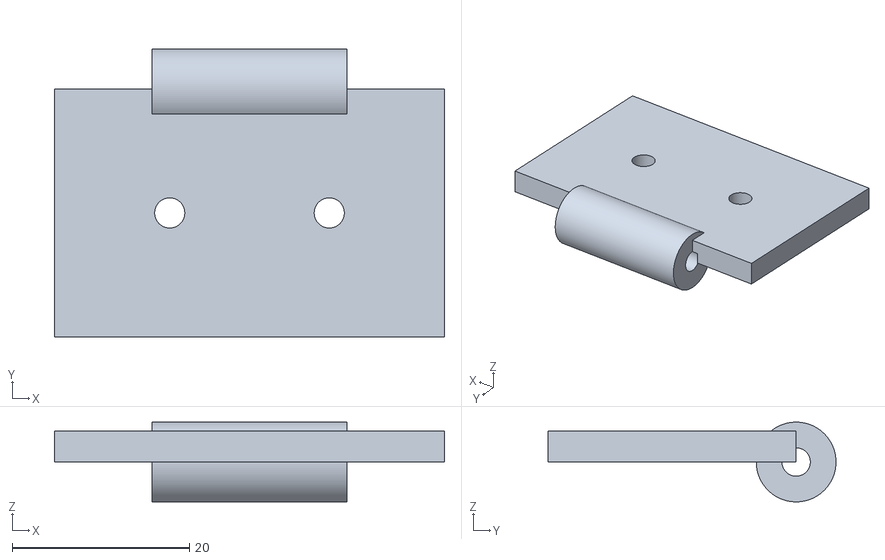
[picture p63: CAD file, 2026-11-11]
outputs/p3/stl/hinge_case_2.stl
44.0 x 32.5 x 9.00
