bensdev-p/retro_machine_cad/outputs/prototype/parts/base_left.step

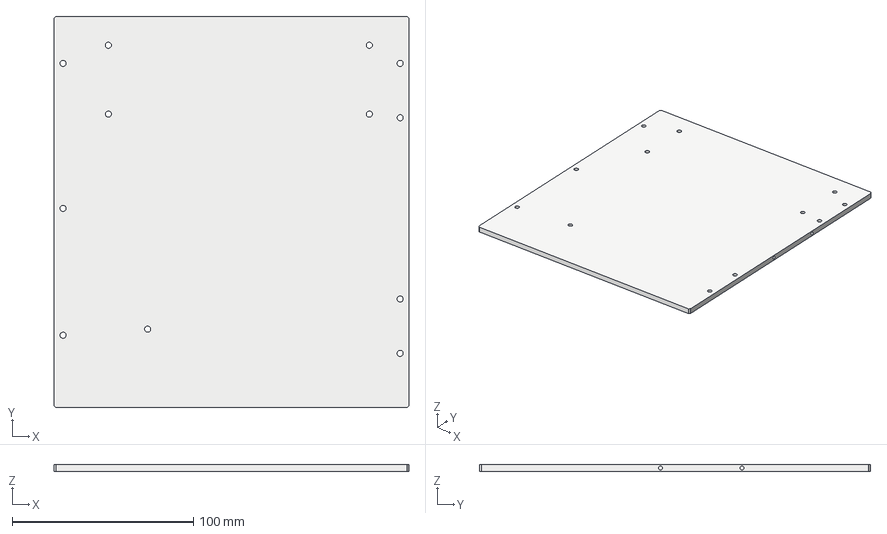
[picture p64: CAD file, 2026-11-05]
outputs/prototype/parts/base_left.step
195.9 x 216.0 x 4.00 mm
