bensdev-p/retro_machine_cad/outputs/step_parts/drive_1_rear_cable.step

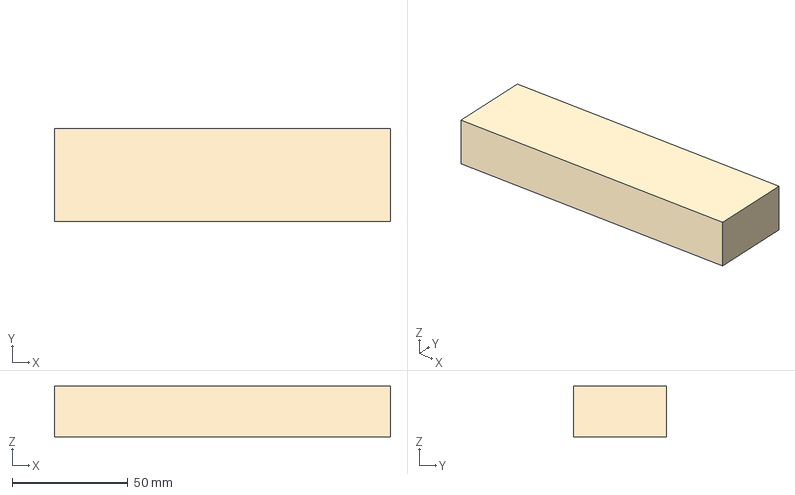
[picture p65: CAD file, 2026-11-05]
outputs/step_parts/drive_1_rear_cable.step
145.0 x 40.0 x 22.0 mm
