bensdev-p/retro_machine_cad/outputs/p3/stl/latch_base_right.stl

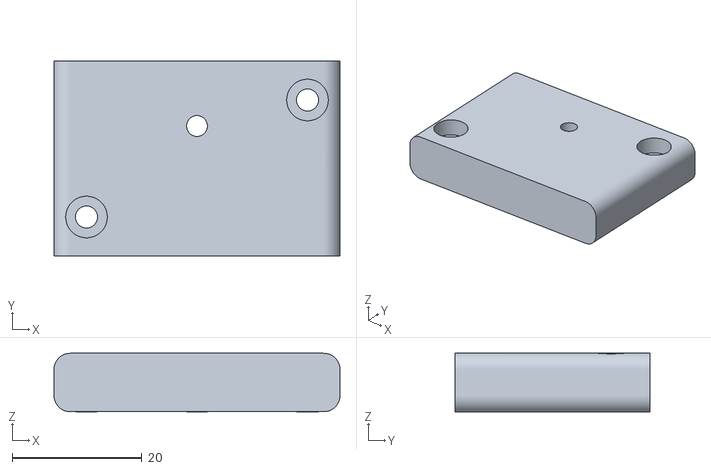
[picture p67: CAD file, 2026-11-11]
outputs/p3/stl/latch_base_right.stl
44.0 x 30.0 x 9.00
