bensdev-p/retro_machine_cad/outputs/prototype/parts/TEST_fasteners.step

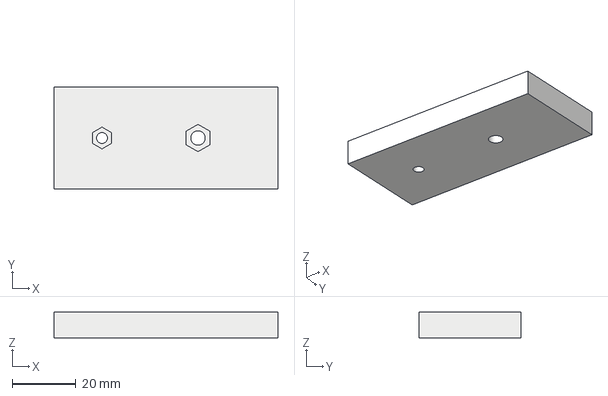
[picture p68: CAD file, 2026-11-05]
outputs/prototype/parts/TEST_fasteners.step
70.0 x 32.0 x 8.00 mm
