bensdev-p/retro_machine_cad/outputs/step_parts/pi_USB_Ethernet_exit.step

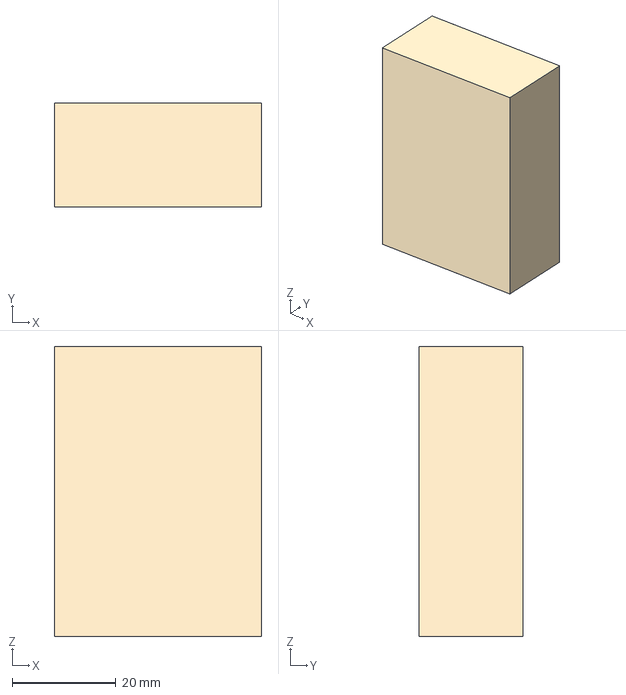
[picture p69: CAD file, 2026-11-05]
outputs/step_parts/pi_USB_Ethernet_exit.step
40.0 x 20.0 x 56.0 mm
