bensdev-p/retro_machine_cad/outputs/p3/stl/drawer.stl

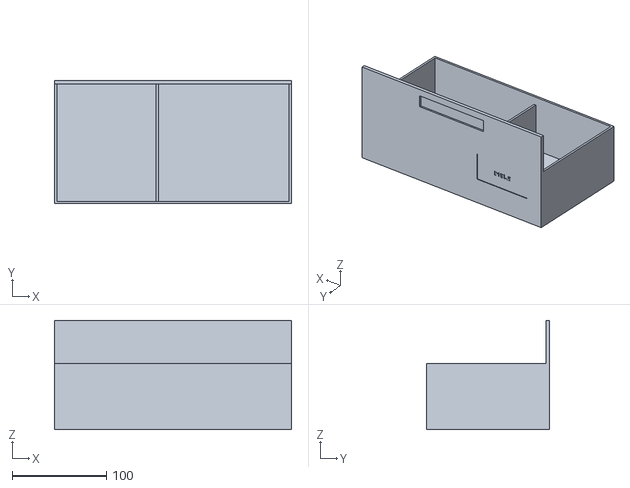
[picture p70: CAD file, 2026-11-11]
outputs/p3/stl/drawer.stl
252.0 x 131.0 x 116.0
