bensdev-p/retro_machine_cad/outputs/prototype/parts/power_strain_relief.step

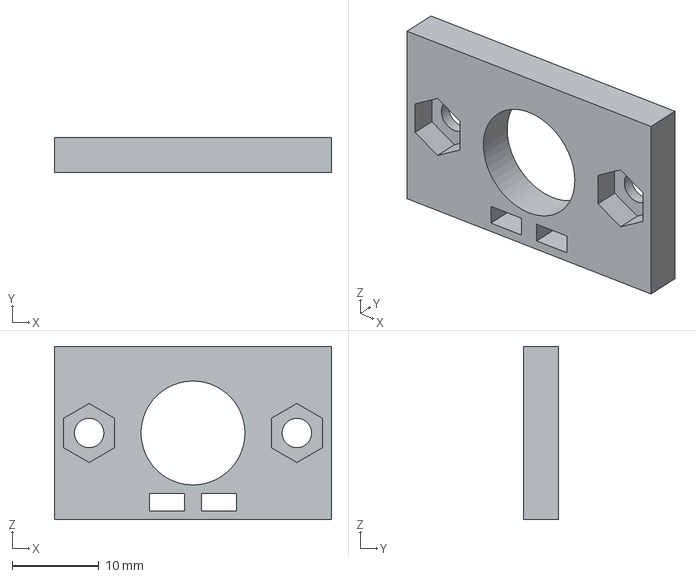
[picture p71: CAD file, 2026-11-05]
outputs/prototype/parts/power_strain_relief.step
32.0 x 4.00 x 20.0 mm
