bensdev-p/retro_machine_cad/outputs/prototype/parts/base_seam_1.step

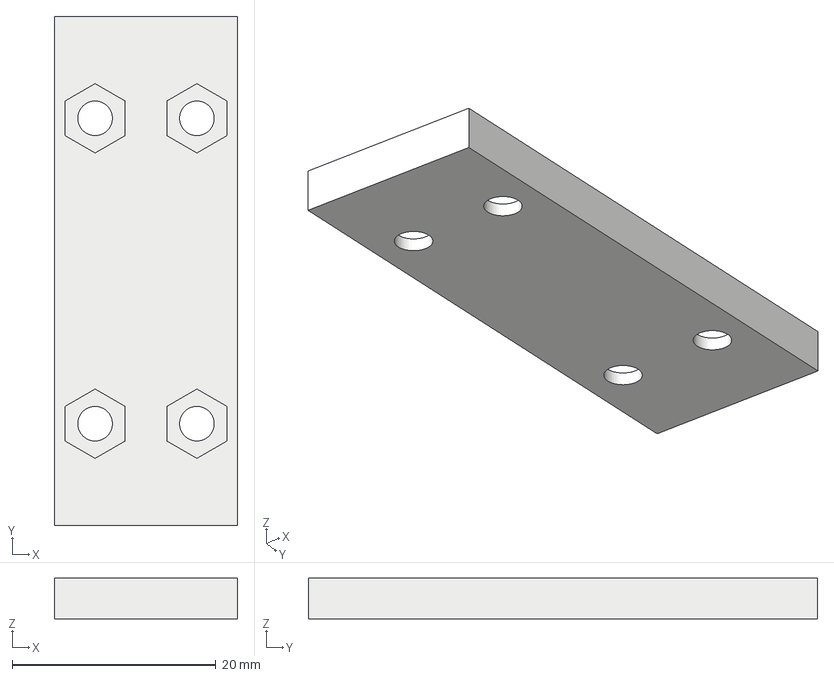
[picture p72: CAD file, 2026-11-05]
outputs/prototype/parts/base_seam_1.step
18.0 x 50.0 x 4.00 mm
