bensdev-p/retro_machine_cad/outputs/step_parts/touch_keepout.step

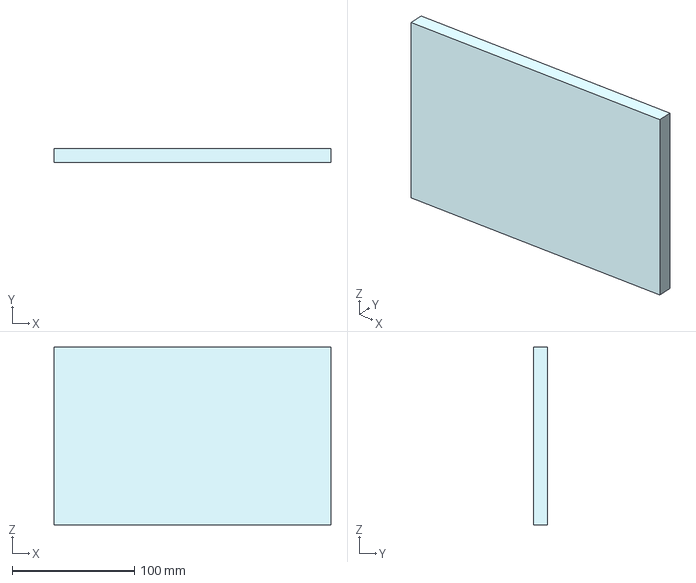
[picture p73: CAD file, 2026-11-05]
outputs/step_parts/touch_keepout.step
226.6 x 11.8 x 145.4 mm
