bensdev-p/retro_machine_cad/outputs/p3/stl/shell_right__inlay_side_right.stl

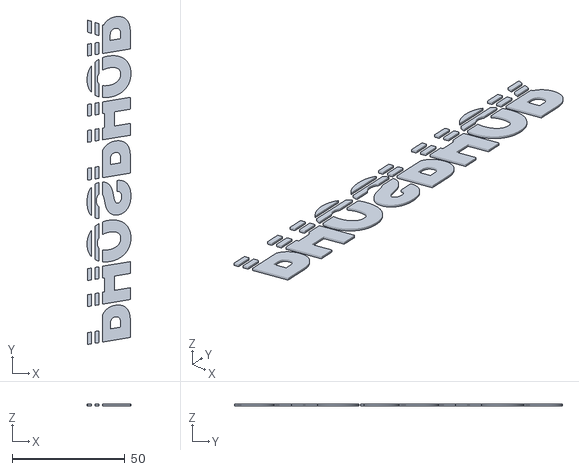
[picture p74: CAD file, 2026-11-11]
outputs/p3/stl/shell_right__inlay_side_right.stl
19.5 x 145.6 x 0.8
