bensdev-p/retro_machine_cad/outputs/prototype/parts/screen_support_2.step

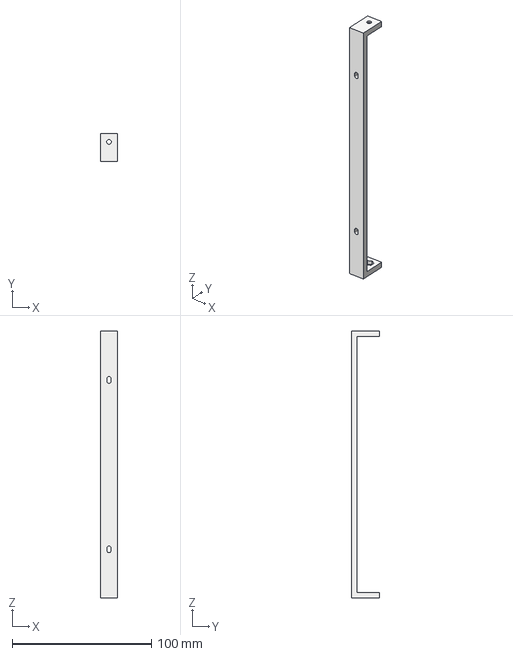
[picture p75: CAD file, 2026-11-05]
outputs/prototype/parts/screen_support_2.step
12.0 x 20.0 x 192.0 mm
