bensdev-p/retro_machine_cad/outputs/p3/stl/lid_right.stl

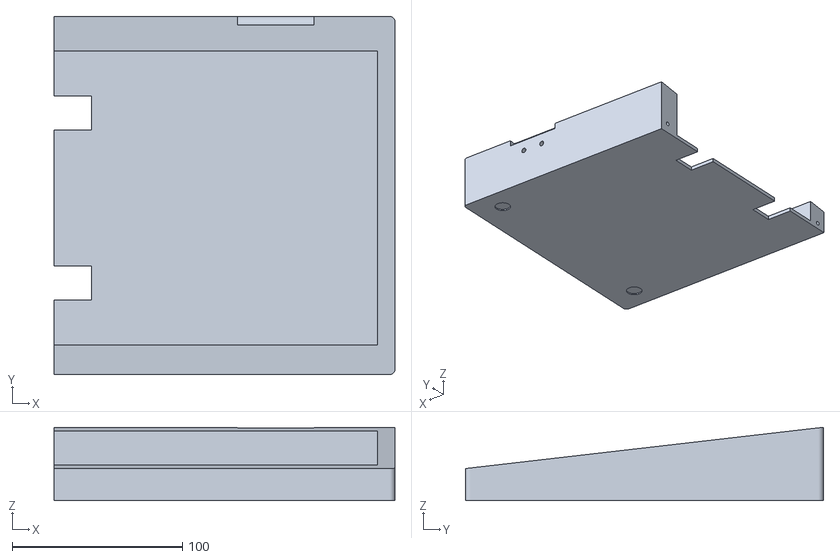
[picture p76: CAD file, 2026-11-11]
outputs/p3/stl/lid_right.stl
200.0 x 210.0 x 43.1
