bensdev-p/retro_machine_cad/outputs/step_parts/drive_2_placeholder.step

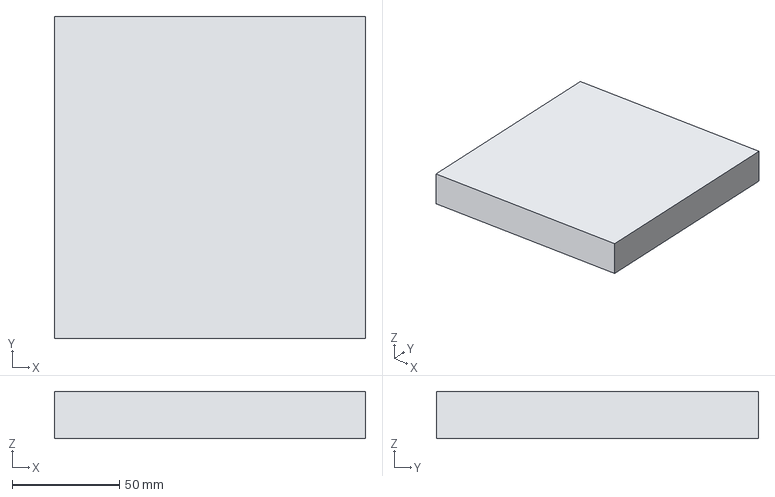
[picture p77: CAD file, 2026-11-05]
outputs/step_parts/drive_2_placeholder.step
145.0 x 150.0 x 22.0 mm
