bensdev-p/retro_machine_cad/outputs/prototype/parts/hub_cradle.step

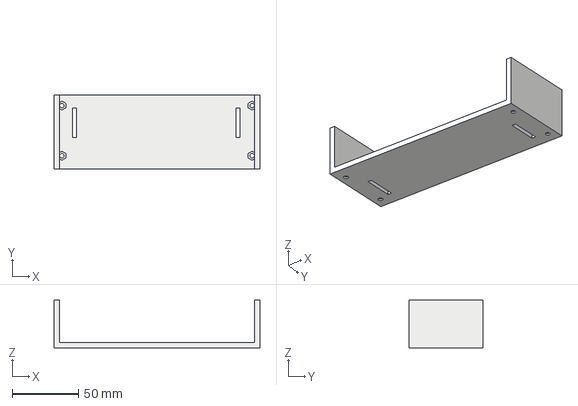
[picture p79: CAD file, 2026-11-05]
outputs/prototype/parts/hub_cradle.step
156.0 x 56.0 x 36.0 mm
