bensdev-p/retro_machine_cad/outputs/step_parts/pi_power_HDMI_exit.step

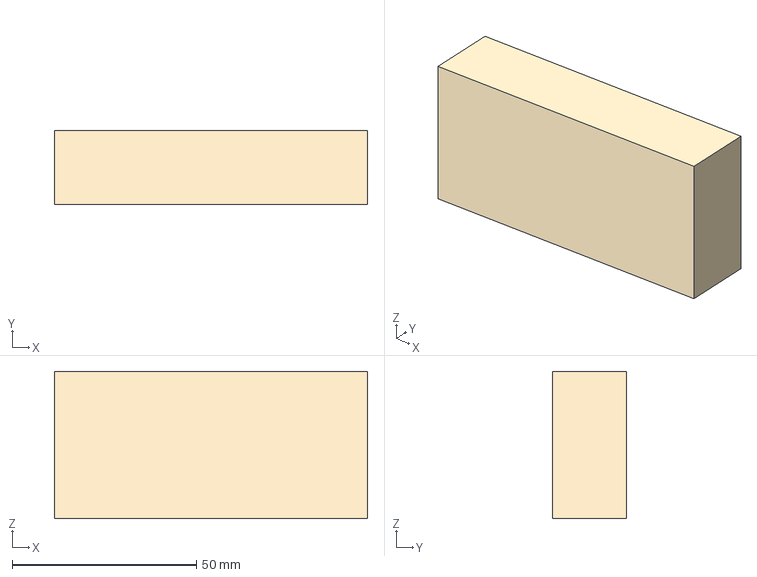
[picture p80: CAD file, 2026-11-05]
outputs/step_parts/pi_power_HDMI_exit.step
85.0 x 20.0 x 40.0 mm
