bensdev-p/retro_machine_cad/outputs/p3/stl/coupon_C3_seam_R.stl

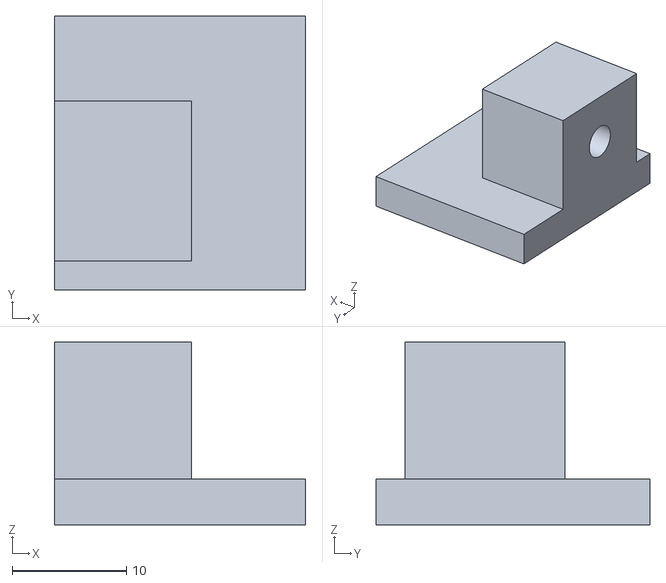
[picture p81: CAD file, 2026-11-11]
outputs/p3/stl/coupon_C3_seam_R.stl
22.0 x 24.0 x 16.0
