bensdev-p/retro_machine_cad/outputs/p3/stl/bezel_screen__bezel_screen_face.stl

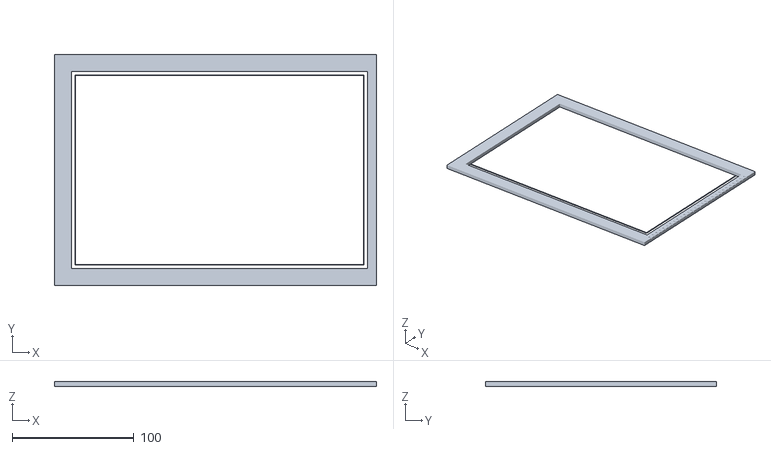
[picture p82: CAD file, 2026-11-11]
outputs/p3/stl/bezel_screen__bezel_screen_face.stl
264.0 x 189.0 x 4.00
