bensdev-p/retro_machine_cad/outputs/prototype/parts/drive_cage_join_0.step

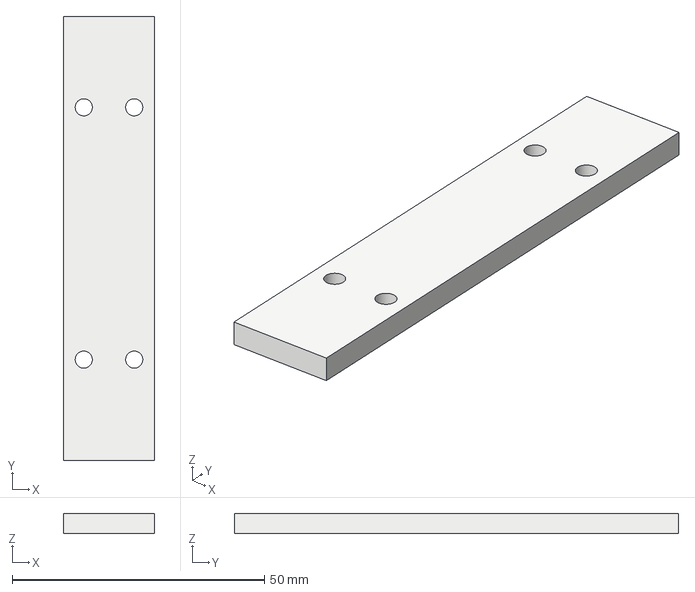
[picture p83: CAD file, 2026-11-05]
outputs/prototype/parts/drive_cage_join_0.step
18.0 x 88.0 x 4.00 mm
