bensdev-p/retro_machine_cad/outputs/step_parts/pi_board_nominal.step

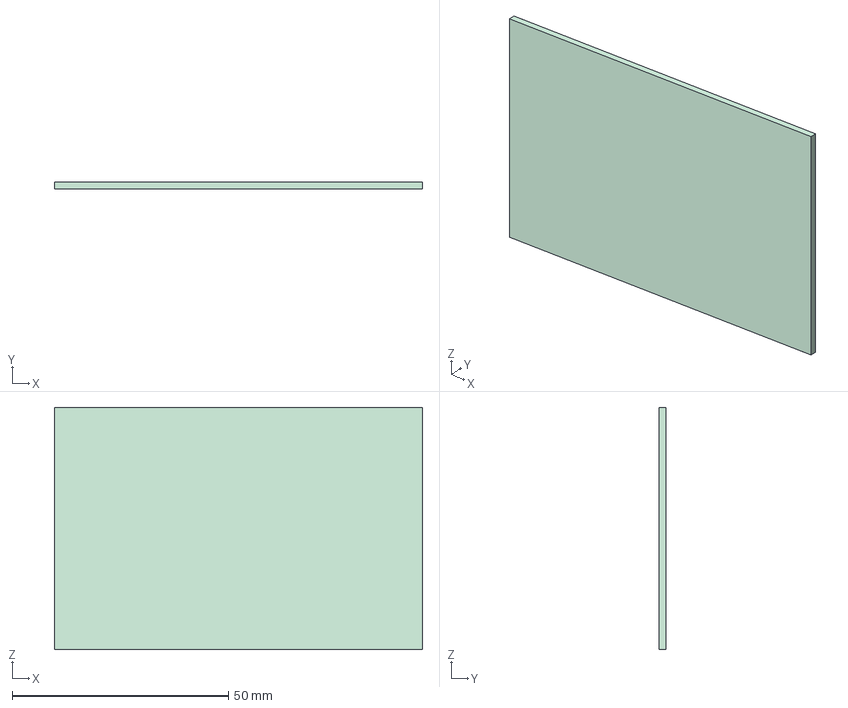
[picture p84: CAD file, 2026-11-05]
outputs/step_parts/pi_board_nominal.step
85.0 x 1.60 x 56.0 mm
