bensdev-p/retro_machine_cad/outputs/p3/stl/display_bracket.stl

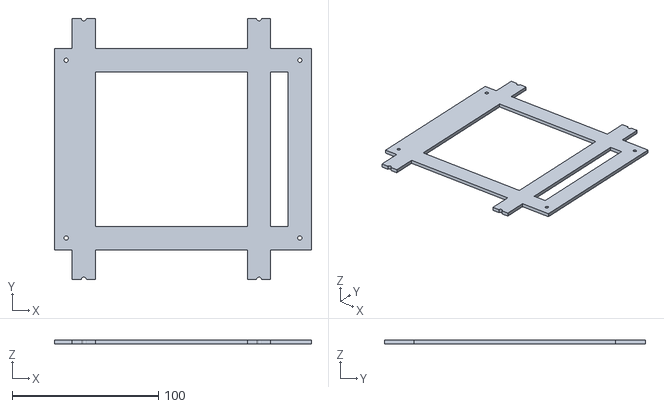
[picture p85: CAD file, 2026-11-11]
outputs/p3/stl/display_bracket.stl
176.0 x 178.9 x 3.00
