bensdev-p/retro_machine_cad/outputs/prototype/parts/TEST_screen_mount.step

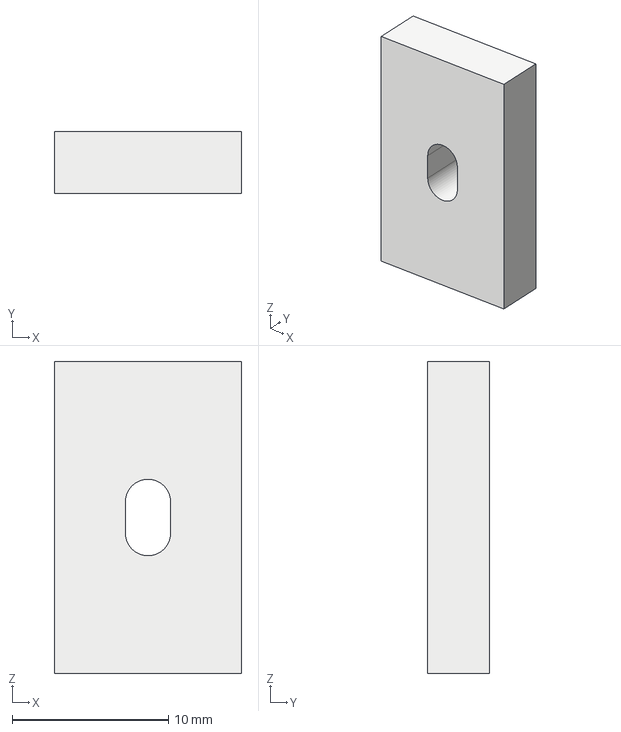
[picture p86: CAD file, 2026-11-05]
outputs/prototype/parts/TEST_screen_mount.step
12.0 x 4.00 x 20.0 mm
