bensdev-p/retro_machine_cad/outputs/prototype/parts/fascia_seam_1.step

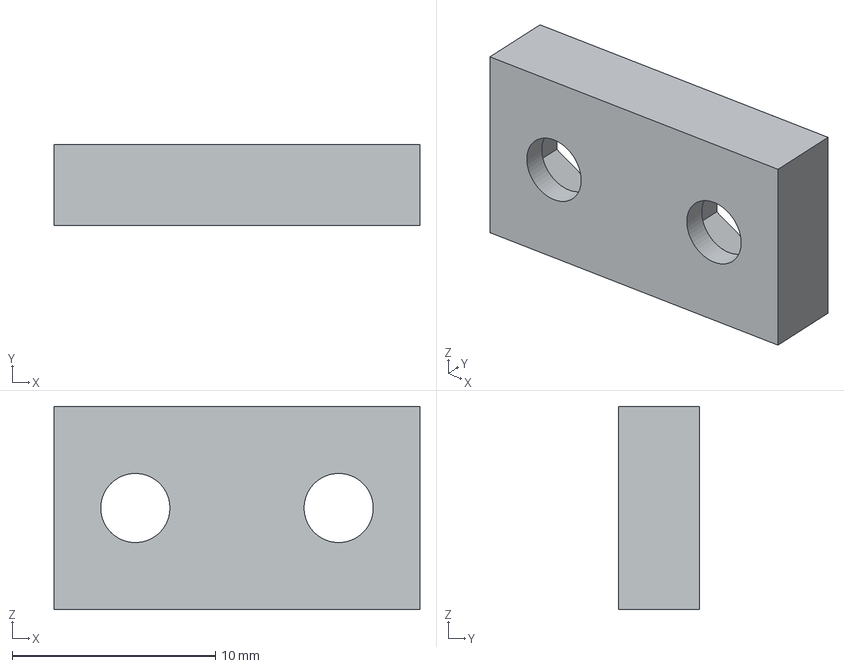
[picture p87: CAD file, 2026-11-05]
outputs/prototype/parts/fascia_seam_1.step
18.0 x 4.00 x 10.0 mm
