bensdev-p/retro_machine_cad/outputs/step_parts/carrier_A_envelope.step

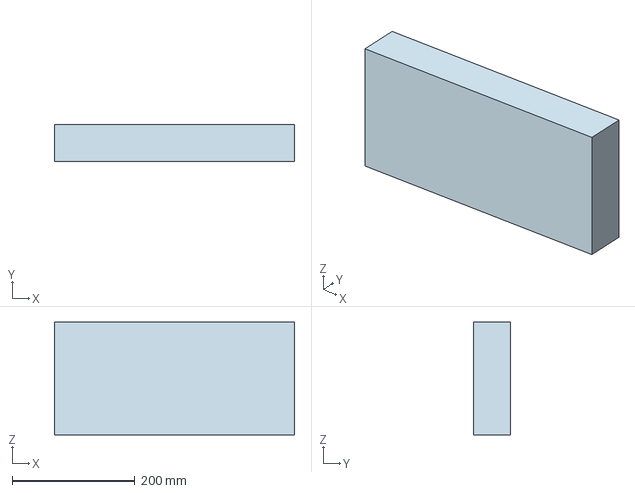
[picture p88: CAD file, 2026-11-05]
outputs/step_parts/carrier_A_envelope.step
390.6 x 59.8 x 183.6 mm
