bensdev-p/retro_machine_cad/outputs/p3/stl/drive_cage.stl

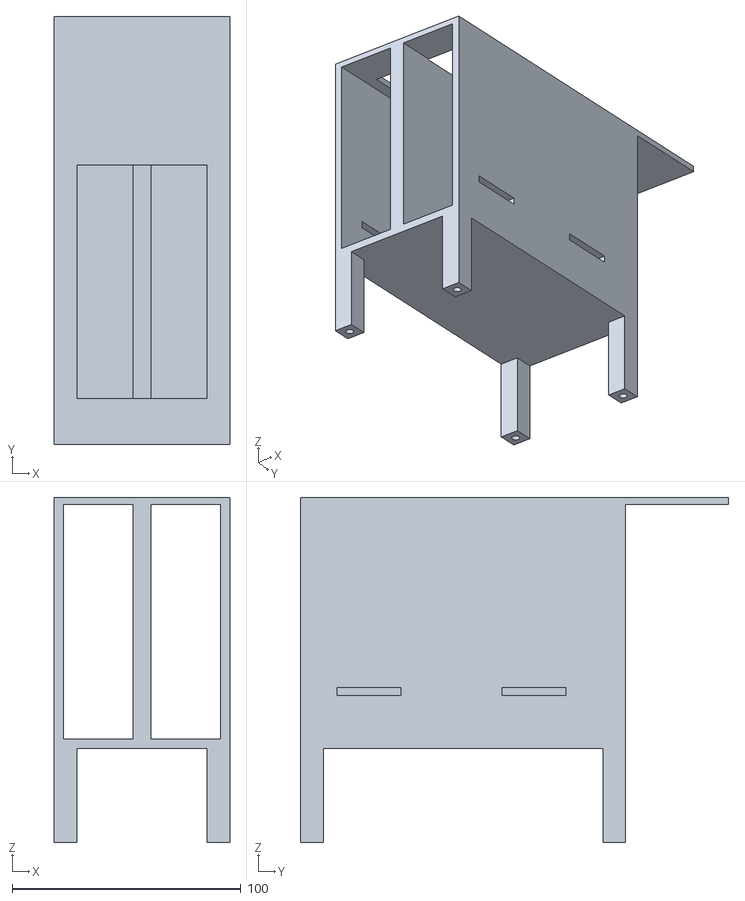
[picture p89: CAD file, 2026-11-11]
outputs/p3/stl/drive_cage.stl
76.8 x 187.0 x 150.8
