bensdev-p/retro_machine_cad/outputs/prototype/parts/drive_cage_join_1.step

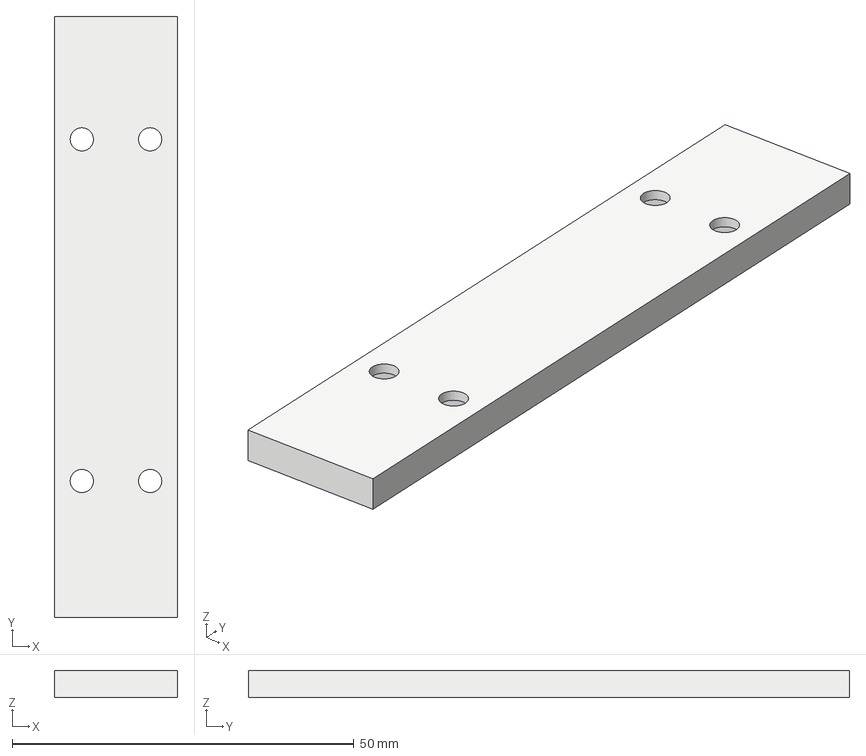
[picture p90: CAD file, 2026-11-05]
outputs/prototype/parts/drive_cage_join_1.step
18.0 x 88.0 x 4.00 mm
