bensdev-p/retro_machine_cad/outputs/step_parts/display_cable_placeholder.step

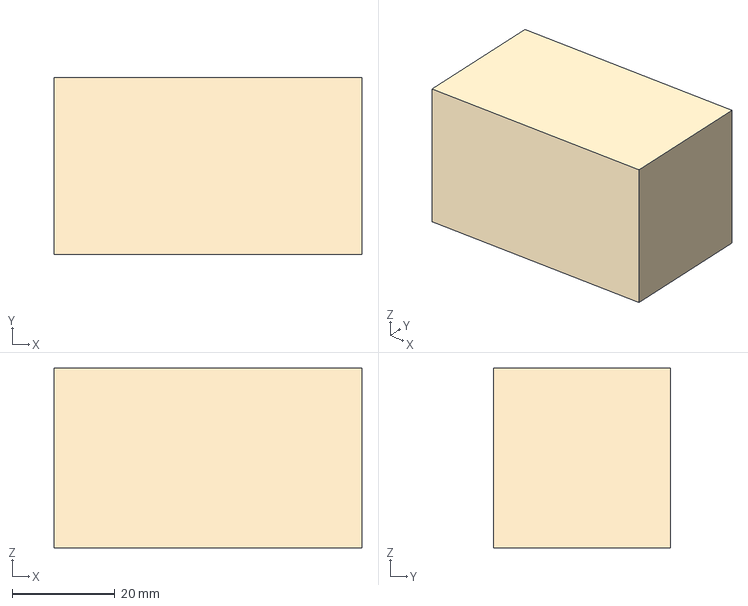
[picture p91: CAD file, 2026-11-05]
outputs/step_parts/display_cable_placeholder.step
60.0 x 34.5 x 35.0 mm
