bensdev-p/retro_machine_cad/outputs/p3/stl/bezel_drives__bezel_drives_face.stl

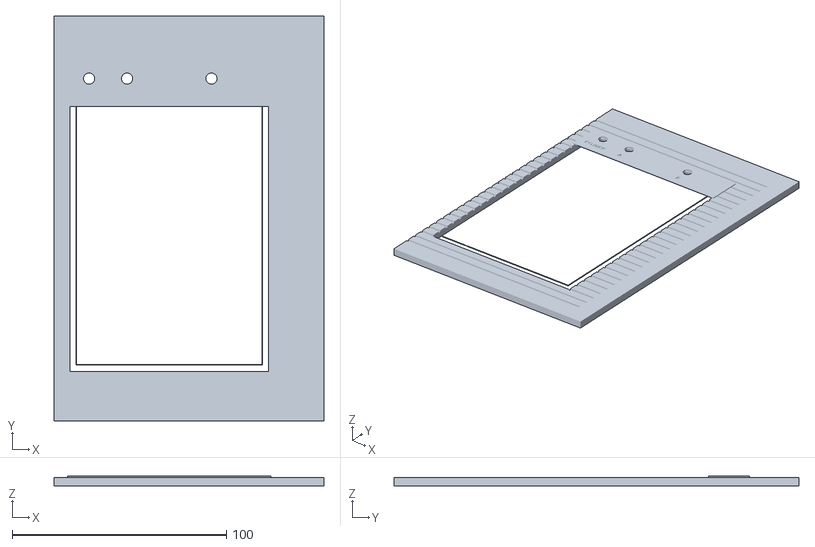
[picture p92: CAD file, 2026-11-11]
outputs/p3/stl/bezel_drives__bezel_drives_face.stl
126.0 x 189.0 x 4.60
