bensdev-p/retro_machine_cad/outputs/prototype/parts/rear_seam.step

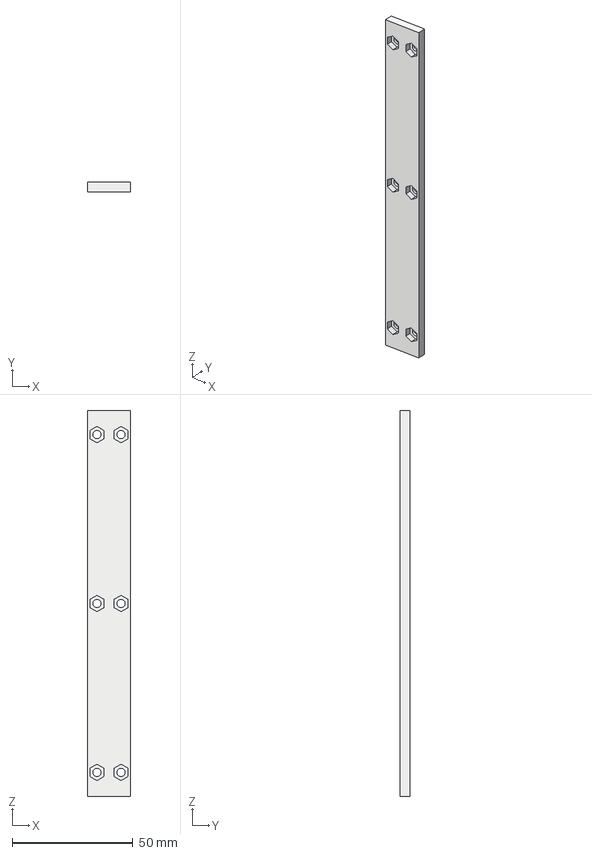
[picture p93: CAD file, 2026-11-05]
outputs/prototype/parts/rear_seam.step
18.0 x 4.00 x 160.0 mm
