bensdev-p/retro_machine_cad/outputs/step_parts/cooler_air_keepout.step

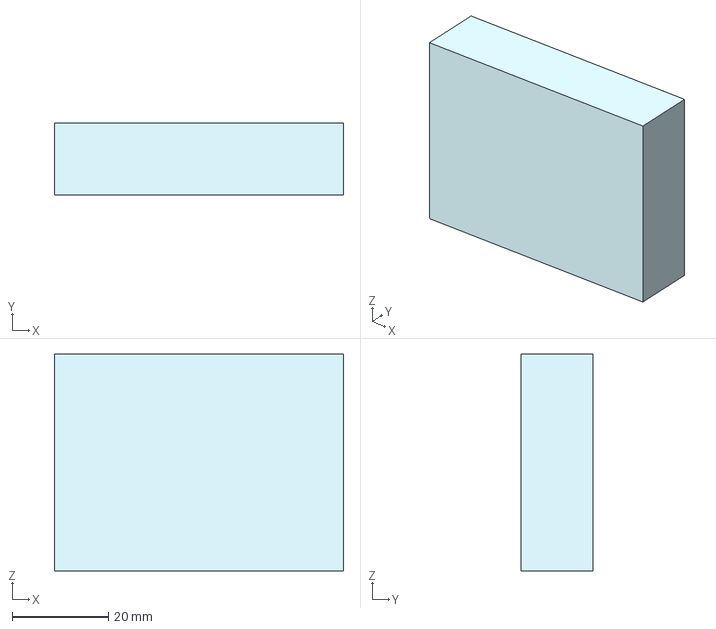
[picture p94: CAD file, 2026-11-05]
outputs/step_parts/cooler_air_keepout.step
60.0 x 15.0 x 45.0 mm
