bensdev-p/retro_machine_cad/outputs/p3/stl/coupon_C1_insert_holes.stl

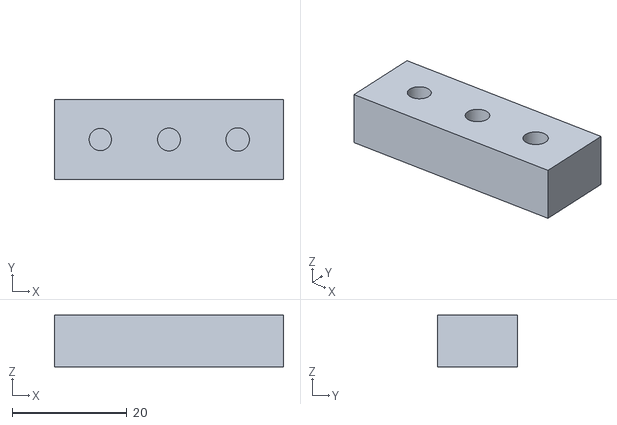
[picture p95: CAD file, 2026-11-08]
outputs/p3/stl/coupon_C1_insert_holes.stl
40.0 x 14.0 x 9.00
