bensdev-p/retro_machine_cad/outputs/prototype/parts/TEST_keyboard_retention.step

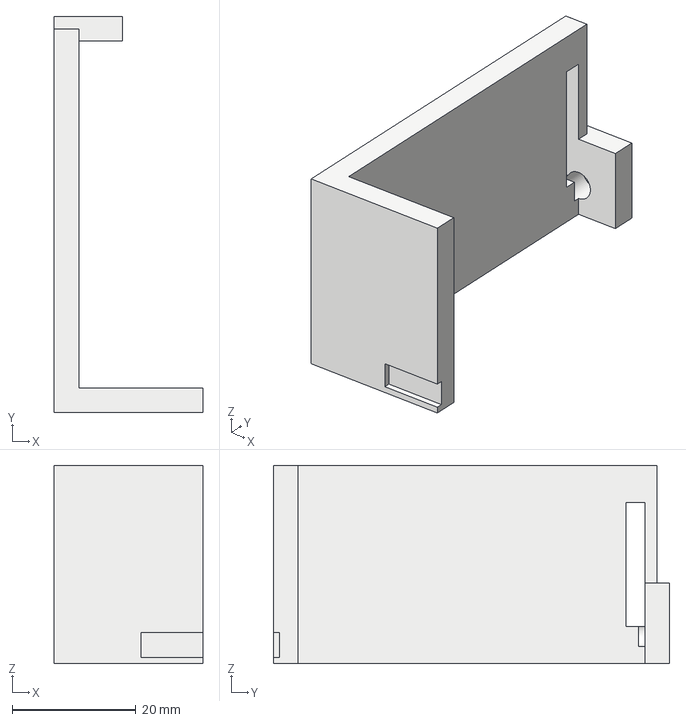
[picture p96: CAD file, 2026-11-05]
outputs/prototype/parts/TEST_keyboard_retention.step
24.0 x 64.0 x 32.0 mm
