bensdev-p/retro_machine_cad/outputs/p3/stl/foot_case_2.stl

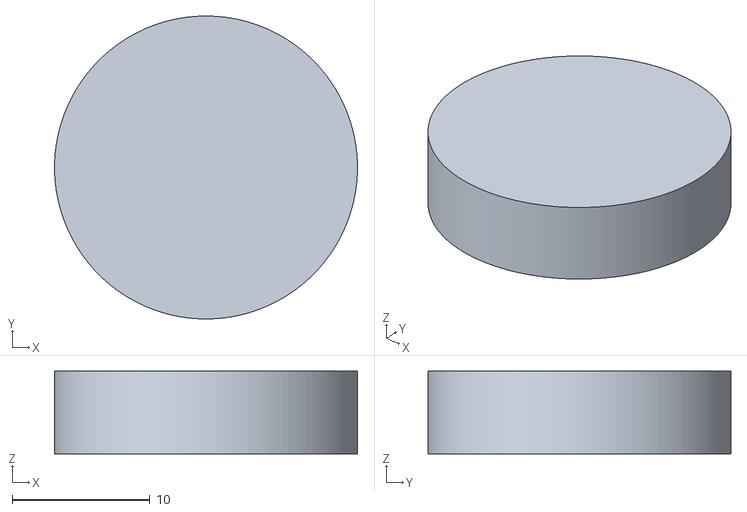
[picture p97: CAD file, 2026-11-08]
outputs/p3/stl/foot_case_2.stl
22.0 x 22.0 x 6.00
