bensdev-p/retro_machine_cad/outputs/prototype/parts/carrier_right.step

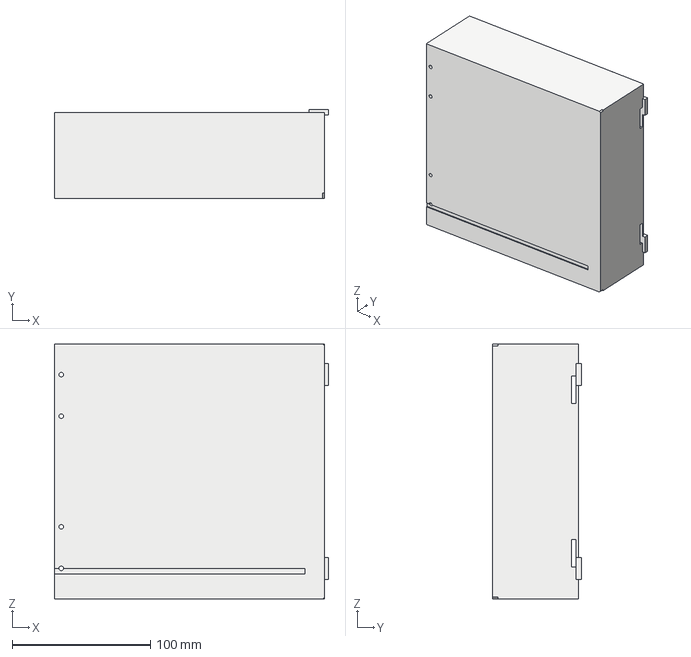
[picture p98: CAD file, 2026-11-05]
outputs/prototype/parts/carrier_right.step
197.9 x 64.0 x 184.0 mm
