bensdev-p/retro_machine_cad/outputs/p3/stl/foot_lid_4.stl

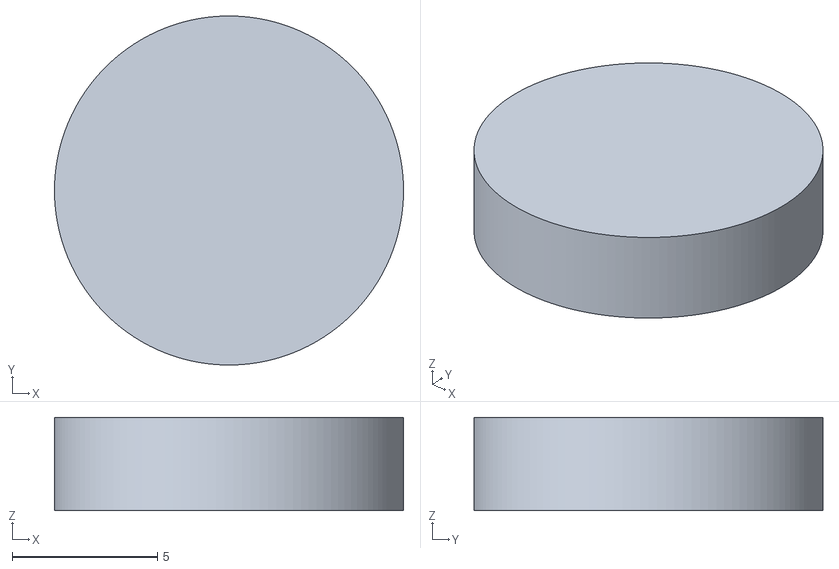
[picture p99: CAD file, 2026-11-08]
outputs/p3/stl/foot_lid_4.stl
12.0 x 12.0 x 3.20
