bensdev-p/retro_machine_cad/outputs/p3/stl/handle.stl

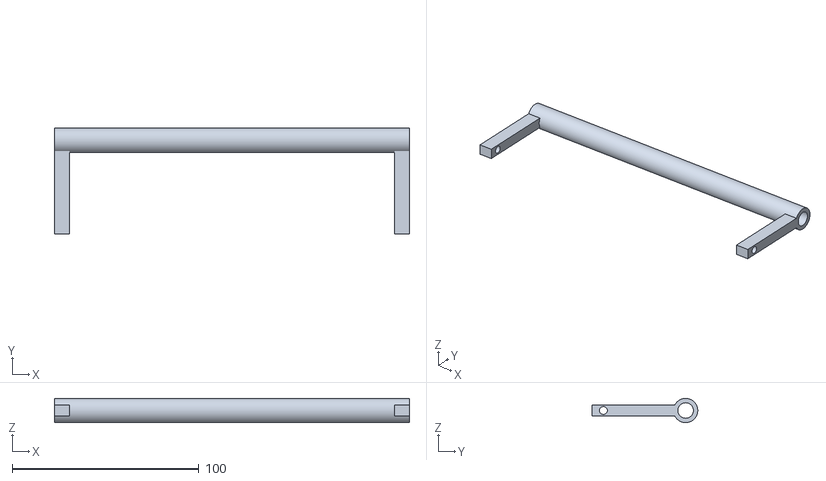
[picture p101: CAD file, 2026-11-08]
outputs/p3/stl/handle.stl
190.0 x 56.5 x 13.0
