bensdev-p/retro_machine_cad/outputs/p3/stl/rear_panel_left.stl

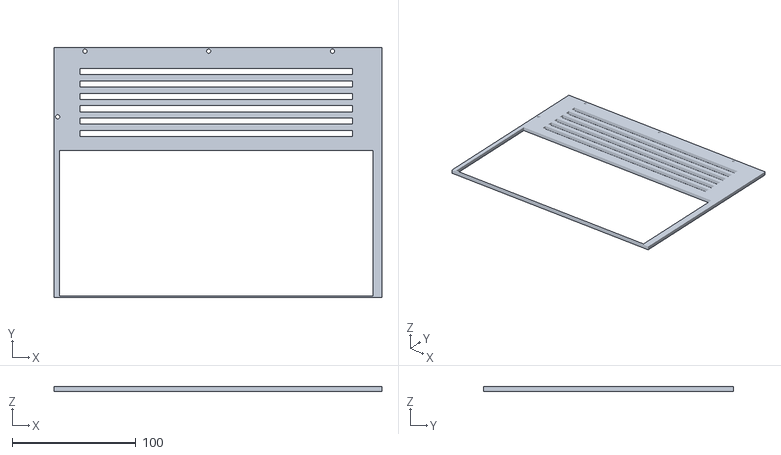
[picture p102: CAD file, 2026-11-08]
outputs/p3/stl/rear_panel_left.stl
265.0 x 202.0 x 4.00
