bensdev-p/retro_machine_cad/outputs/prototype/parts/TEST_screen_corner.step

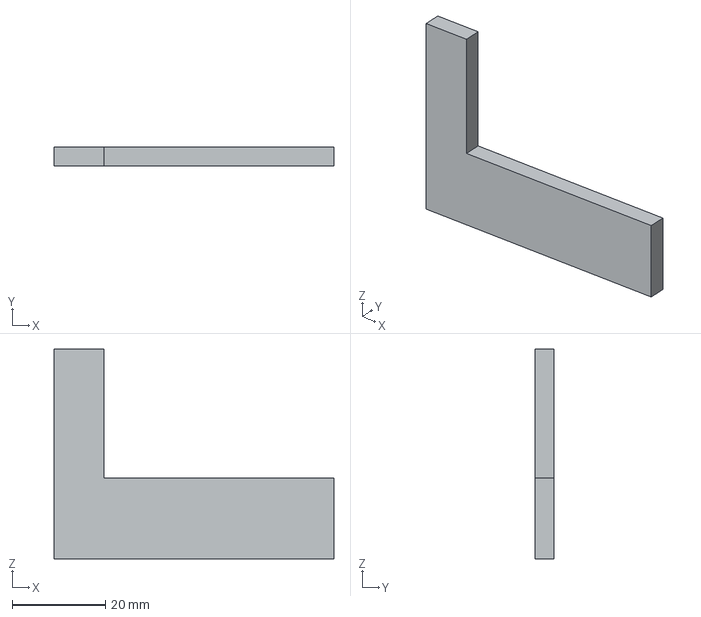
[picture p103: CAD file, 2026-11-05]
outputs/prototype/parts/TEST_screen_corner.step
60.0 x 4.00 x 45.0 mm
