bensdev-p/retro_machine_cad/outputs/p3/stl/bezel_drives__inlay_nameplate.stl

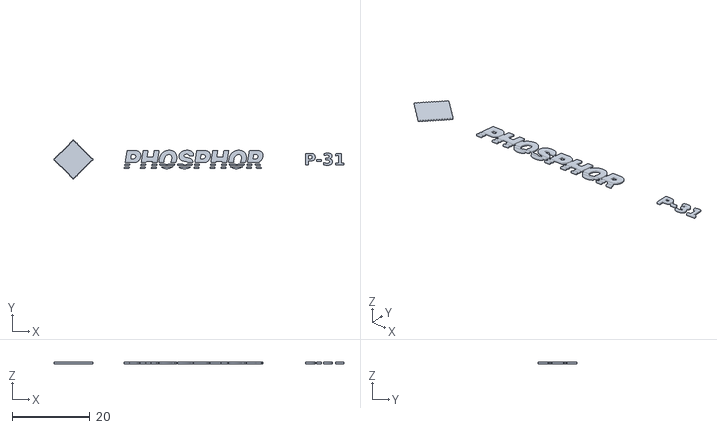
[picture p104: CAD file, 2026-11-08]
outputs/p3/stl/bezel_drives__inlay_nameplate.stl
74.8 x 10.0 x 0.4
