bensdev-p/retro_machine_cad/outputs/prototype/parts/TEST_drive_face.step

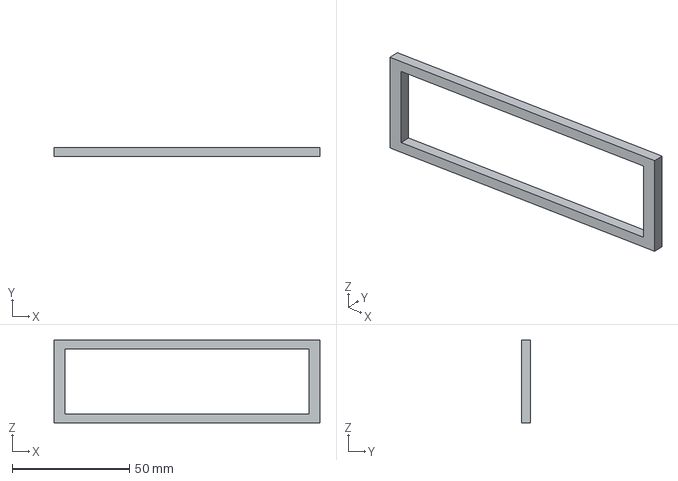
[picture p105: CAD file, 2026-11-05]
outputs/prototype/parts/TEST_drive_face.step
113.6 x 4.00 x 35.4 mm
