bensdev-p/retro_machine_cad/outputs/p3/stl/handle_pivot_2.stl

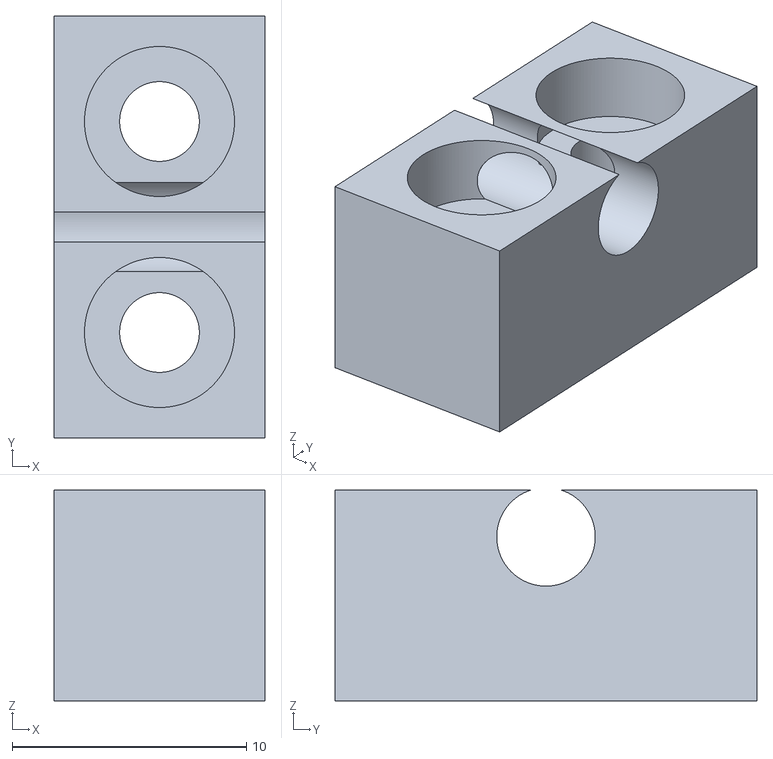
[picture p107: CAD file, 2026-11-08]
outputs/p3/stl/handle_pivot_2.stl
9.00 x 18.0 x 9.00
