bensdev-p/retro_machine_cad/outputs/prototype/parts/rear_right.step

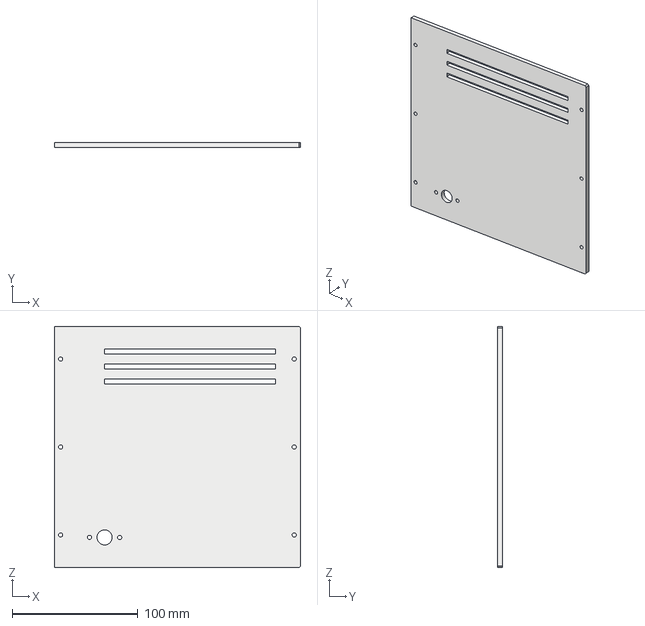
[picture p108: CAD file, 2026-11-05]
outputs/prototype/parts/rear_right.step
195.9 x 4.00 x 192.0 mm
