bensdev-p/retro_machine_cad/outputs/p3/stl/coupon_C5_inlay__coupon_C5_inlay_letters.stl

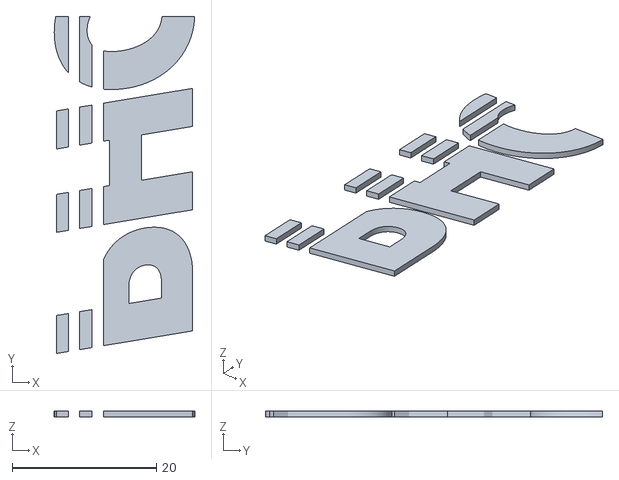
[picture p109: CAD file, 2026-11-08]
outputs/p3/stl/coupon_C5_inlay__coupon_C5_inlay_letters.stl
19.5 x 46.8 x 0.8
