bensdev-p/retro_machine_cad/outputs/p3/stl/rear_io_plate.stl

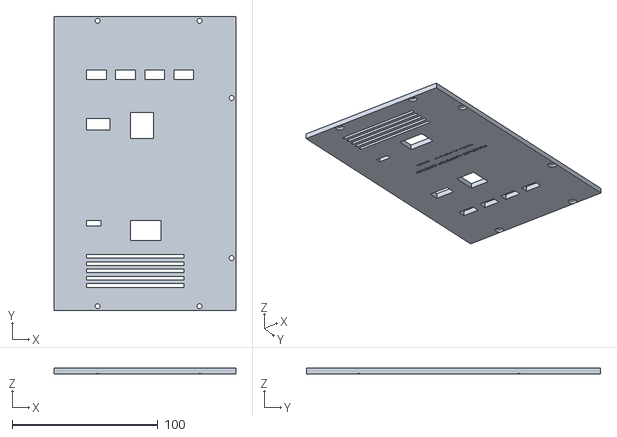
[picture p110: CAD file, 2026-11-08]
outputs/p3/stl/rear_io_plate.stl
125.0 x 202.0 x 4.00
