bensdev-p/retro_machine_cad/outputs/prototype/parts/rear_hub_plate.step

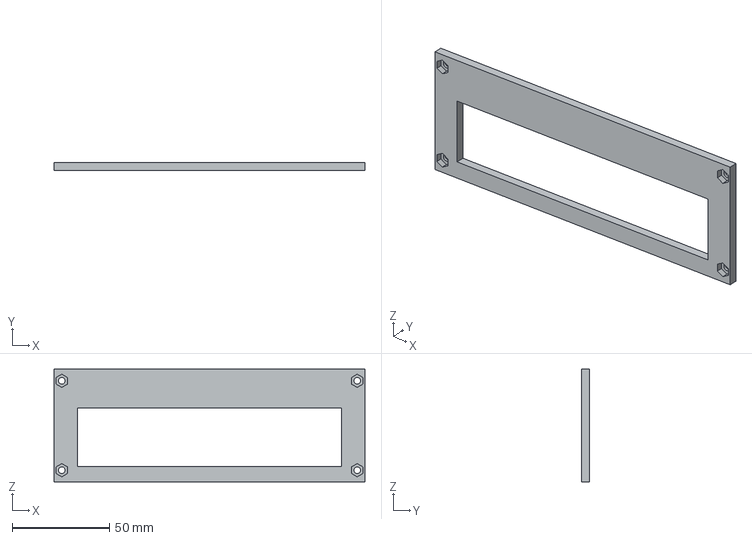
[picture p111: CAD file, 2026-11-05]
outputs/prototype/parts/rear_hub_plate.step
160.0 x 4.00 x 58.0 mm
