bensdev-p/retro_machine_cad/outputs/p3/stl/lid_left__inlay_lid_face.stl

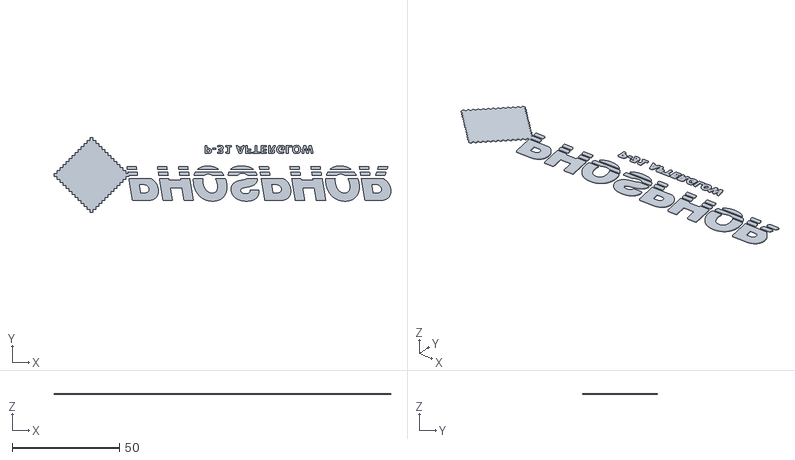
[picture p112: CAD file, 2026-11-08]
outputs/p3/stl/lid_left__inlay_lid_face.stl
157.1 x 35.0 x 0.6
