bensdev-p/retro_machine_cad/outputs/prototype/parts/brand_badge.step

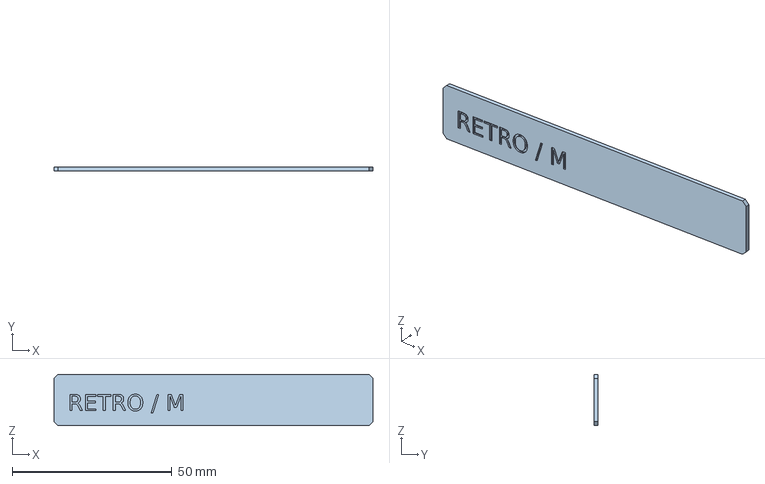
[picture p113: CAD file, 2026-11-05]
outputs/prototype/parts/brand_badge.step
100.0 x 1.20 x 16.0 mm
