bensdev-p/retro_machine_cad/outputs/prototype/parts/fascia_right.step

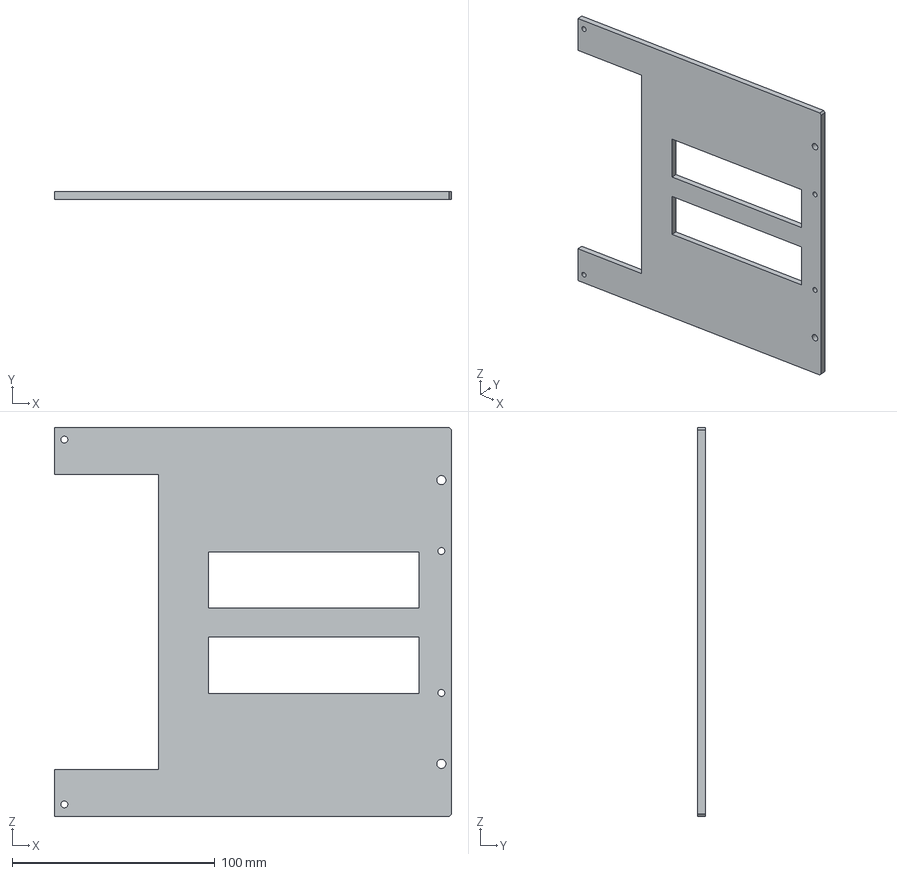
[picture p114: CAD file, 2026-11-05]
outputs/prototype/parts/fascia_right.step
195.9 x 4.00 x 192.0 mm
