bensdev-p/retro_machine_cad/(list of files, cad)

Other CAD files:
outputs/layout_selected.step
outputs/p3/stl/lid_splice_1.stl
outputs/prototype/parts/side_right.step
outputs/prototype/parts/TEST_alignment_right.step
outputs/step_parts/display_outer_mount_axis_1.step
outputs/p3/stl/hinge_lid_1.stl
outputs/step_parts/display_outer_mount_axis_4.step
outputs/step_parts/display_inner_mount_axis_4.step
outputs/p3/stl/latch_base_left.stl
outputs/step_parts/display_inner_mount_axis_1.step
outputs/p3/stl/keyboard_clip_2.stl
outputs/prototype/parts/carrier_seam_1.step
outputs/step_parts/drive_2_disk_access.step
outputs/prototype/parts/base_seam_2.step
outputs/prototype/parts/carrier_blue_inlay_left.step
outputs/step_parts/drive_2_rear_cable.step
outputs/step_parts/display_inner_mount_axis_2.step
outputs/p3/stl/latch_lever_left.stl
outputs/prototype/parts/rim_spacer_right_30.step
outputs/step_parts/display_outer_mount_axis_2.step
outputs/p3/stl/hinge_case_1.stl
outputs/step_parts/keyboard_A_stock_envelope.step
outputs/p3/stl/shell_left__inlay_side_left.stl
outputs/prototype/parts/handle_clamp_1.step
outputs/step_parts/drive_1_placeholder.step
outputs/step_parts/display_outer_mount_axis_3.step
outputs/prototype/parts/drive_cage_left.step
outputs/prototype/parts/carrier_seam_2.step
outputs/prototype/parts/rim_spacer_left_30.step
outputs/prototype/parts/top_seam_1.step
outputs/prototype/parts/base_right.step
outputs/prototype/parts/carrier_left.step
outputs/prototype/parts/front_rim_left.step
outputs/p3/stl/handle_pivot_1.stl
outputs/prototype/parts/rim_spacer_left_170.step
outputs/prototype/parts/fascia_seam_2.step
outputs/prototype/parts/top_seam_2.step
outputs/prototype/parts/drive_cage_join_2.step
outputs/prototype/parts/screen_support_1.step
outputs/prototype/parts/top_left.step
outputs/prototype/parts/top_right.step
outputs/p3/stl/bezel_drives.stl
outputs/p3/stl/bezel_screen.stl
outputs/p3/stl/coupon_C5_inlay.stl
outputs/p3/stl/lid_left.stl
outputs/p3/stl/shell_left.stl
outputs/p3/stl/shell_right.stl
outputs/prototype/parts/TEST_alignment_left.stl
outputs/prototype/parts/TEST_alignment_right.stl
outputs/prototype/parts/TEST_drive_face.stl
outputs/prototype/parts/TEST_fasteners.stl
outputs/prototype/parts/TEST_keyboard_retention.stl
outputs/prototype/parts/TEST_screen_corner.stl
outputs/prototype/parts/TEST_screen_mount.stl
outputs/prototype/parts/base_left.stl
outputs/prototype/parts/base_right.stl
outputs/prototype/parts/base_seam_1.stl
outputs/prototype/parts/base_seam_2.stl
outputs/prototype/parts/brand_badge.stl
outputs/prototype/parts/carrier_blue_inlay_left.stl
outputs/prototype/parts/carrier_blue_inlay_right.stl
outputs/prototype/parts/carrier_left.stl
outputs/prototype/parts/carrier_right.stl
outputs/prototype/parts/carrier_seam_1.stl
outputs/prototype/parts/carrier_seam_2.stl
outputs/prototype/parts/drive_cage_join_0.stl
outputs/prototype/parts/drive_cage_join_1.stl
outputs/prototype/parts/drive_cage_join_2.stl
outputs/prototype/parts/drive_cage_left.stl
outputs/prototype/parts/drive_cage_right.stl
outputs/prototype/parts/fascia_left.stl
outputs/prototype/parts/fascia_right.stl
outputs/prototype/parts/fascia_seam_1.stl
outputs/prototype/parts/fascia_seam_2.stl
outputs/prototype/parts/front_rim_left.stl
outputs/prototype/parts/front_rim_right.stl
outputs/prototype/parts/handle_clamp_1.stl
outputs/prototype/parts/handle_clamp_2.stl
outputs/prototype/parts/hub_cradle.stl
outputs/prototype/parts/power_strain_relief.stl
outputs/prototype/parts/rear_hub_plate.stl
outputs/prototype/parts/rear_left.stl
outputs/prototype/parts/rear_right.stl
outputs/prototype/parts/rear_seam.stl
outputs/prototype/parts/rim_spacer_left_170.stl
outputs/prototype/parts/rim_spacer_left_30.stl
outputs/prototype/parts/rim_spacer_right_170.stl
outputs/prototype/parts/rim_spacer_right_30.stl
outputs/prototype/parts/screen_support_1.stl
outputs/prototype/parts/screen_support_2.stl
outputs/prototype/parts/side_left.stl
outputs/prototype/parts/side_right.stl
outputs/prototype/parts/top_left.stl
outputs/prototype/parts/top_right.stl
outputs/prototype/parts/top_seam_1.stl
outputs/prototype/parts/top_seam_2.stl
