bensdev-p/retro_machine_cad/(commit log)

2026-11-05 Add parametric luggable computer layout and CAD reference exports
    [active_area_reference.step, carrier_A_envelope.step, case_envelope.step, cooler_air_keepout.step, cooler_placeholder.step, display_cable_placeholder.step, display_inner_mount_axis_1.step, display_inner_mount_axis_2.step]
2026-11-05 Build P1 printable enclosure with carrier, mounts, validation and CAD renders
    [TEST_alignment_left.step, TEST_alignment_left.stl, TEST_alignment_right.step, TEST_alignment_right.stl, TEST_drive_face.step, TEST_drive_face.stl, TEST_fasteners.step, TEST_fasteners.stl]
2026-11-06 Add P2 Kaypro-style luggable concept: shielded fascia, keyboard lid, vertical drives, rear drawer
    - cad/p2_concept.py: parametric build123d massing model with operating/closed/rear states
    and interference/clearance checks (all pass)
    - Offline three.js viewer, STEP assemblies, preview renders, two colourways
    - docs/concept-P2.md: rationale, dimensions, assumptions and next steps
    Claude-Session: https://claude.ai/code/session_0178GCZ574oYFLCgZ2eYzgJq
    [p2_closed.step, p2_operating.step]
2026-11-06 P2 rev B: Kaypro wedge keyboard lid and matching slanted case lip
    - Keyboard housing is now a wedge (deck = keyboard slope + 4 deg platform tilt) that
    doubles as the typing tilt; its underside is the closed front face
    - Case front cut on the same slant so the closed lid meets it flush
    - Swing clips retain the keyboard; latches moved behind the lip
    - Side stripe inlays, stock-8BitDo colourway, side views; checks all pass
    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
    [p2_closed.step, p2_operating.step]
2026-11-06 P2 rev C: hinge the wedge lid so it props the case back when open
    - Lift-off hinge pair on the bottom front edge; axis on the lid's rear deck edge
    - Open state: lid flat on the desk lifts the case front, tilting it back ~10.3 deg (derived)
    - Front feet moved behind the slanted lip; viewer/STEP apply the open-state tilt
    - New checks: open lid/hinges clear case, both rest on the desk; all pass
    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
    [p2_closed.step, p2_operating.step]
2026-11-06 P2: add M Edition-matched colourway and update stock-keyboard colours
    Colours eyeballed from an 8BitDo product photo; renders 11/12 added.
    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
    [p2_closed.step, p2_operating.step]
2026-11-06 P2: Phosphor Computer Company branding and model-name ideas
    - Striped italic PHOSPHOR wordmark on both sides, closed lid face and keyboard deck
    - P1-green / P3-amber / blue phosphor stripes, front-panel nameplate, rear rating plate
    - Branded boot screen in the viewer; branding text parameterised in p2.branding
    - Docs: branding system, print notes, model-name brainstorm
    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
    [p2_closed.step, p2_operating.step]
2026-11-06 P2: align case branding with RetroOS (Phosphor diamond + Phosphor Mono), show POST screen
    - Default branding style 'os': pixel diamond logo (Cobalt/Sky/Aqua/White) and
    Phosphor Mono wordmark from the RetroOS repo; nameplate mirrors the BIOS logo
    - Speed-stripe/phosphor-bar look kept as optional style 'stripes'
    - tools/render_post_screen.py redraws the Phosphor BIOS POST screen at 1920x1200
    for the viewer/renders; Phosphor Mono glyphs vendored (OFL)
    - Docs: branding rewritten, Model 5 naming from RetroOS lore
    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
    [p2_closed.step, p2_operating.step]
2026-11-06 P2 branding: italic speed-cut wordmark everywhere, diamond only on front badges, no stripes
    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
    [p2_closed.step, p2_operating.step]
2026-11-06 P2: floppy subsystem with verified dimensions; two Feather RP2040 + Floppy FeatherWing stacks
    - Drive envelope 146.1 x 101.6 x 25.4 mm (Adafruit 6037) instead of the 150 mm guess
    - Two controller stacks (50.8 x 22.8 mm verified) under the drives, open cage legs,
    28 mm cable keep-out behind the drives, power reservation moved to the front
    - Unverified quantities (stack height, hole positions, connectors, buck) are flagged
    as reservations in parameters.json and listed in the docs
    - New x-ray render of the drive bay
    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
    [p2_closed.step, p2_operating.step]
2026-11-06 Add P2 internals bill of materials (docs/BOM-P2.md)
    Covers core computer, floppy subsystem, power architecture and budget, master and
    soft power switches, USB/rear I/O, audio, front-panel LEDs, keyboard, cooling and
    fasteners, with verified figures sourced and unknowns listed for the user.
    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
    [p2_closed.step, p2_operating.step]
2026-11-08 P3 printable v1: split into 40 print-oriented parts with heat-set joints and printed hardware
    - cad/p3_print.py builds on the P2 geometry: centre-seam shell halves (screw blocks + dowels),
    two-tone multi-part front bezels split at the screen/drive divide, drawer panel + replaceable
    I/O plate, lid halves with recessed splice plates, printed hinges/latches/handle, TPU feet
    - Flush multi-colour inlays for all branding (bed face or top face), exported as 3MF parts
    - Every part oriented for printing and auto-assigned to H2C / X2D / A1 / A1 mini (verified
    bed sizes), manifest, STEP assembly, assembly clearance checks (all pass), fit coupons
    - Placeholder side cutout + keep-out for the IBM-st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
    [bezel_drives.3mf, bezel_drives.stl, bezel_drives__bezel_drives_face.stl, bezel_drives__inlay_nameplate.stl, bezel_screen.3mf, bezel_screen.stl, bezel_screen__bezel_screen_face.stl, coupon_C1_insert_holes.stl]
2026-11-11 Use measured keyboard edge heights (19.05 front / 38.6 rear); deck slope now from measurements
    - Keyboard W/D/H stays at the listing values (user-confirmed); edge heights measured
    - deck_slope was still hard-coded; now derived from the measured edge heights
    - Platform tilt 0 deg (keyboard already slopes 6.6 deg): wedge 18.9 -> 43.1 mm, open tilt 10.9 deg
    - Seam screw blocks now position themselves between the display bosses and the drawer
    - Rebuilt P2 + P3; all checks pass; shell halves now fit the A1
    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
    [bezel_drives.3mf, bezel_drives.stl, bezel_drives__bezel_drives_face.stl, bezel_screen.3mf, bezel_screen.stl, bezel_screen__bezel_screen_face.stl, coupon_C3_seam_L.stl, coupon_C3_seam_R.stl]
